Worigin0314/2025-USTB--IoT-Engineering--Electronic_Circuit_practice/README.md

2025学年北京科技大学物联网工程专业-电子电路实践<br>
这门课算是非常轻松的一门课了，完全跟着老师发的PDF来，结课报告让AI润色一下就是90+，实验操作课上完全能完成，杨XX老师讲的也不错，动手操作环节不难而且很有意思<br>
记得要验收，最后灯体装完了也要验收
