Worigin0314/2025-USTB--IoT-Engineering--Electronic_Circuit_practice/4、2025-讲语音设计及固件烧录-CI1302.pdf

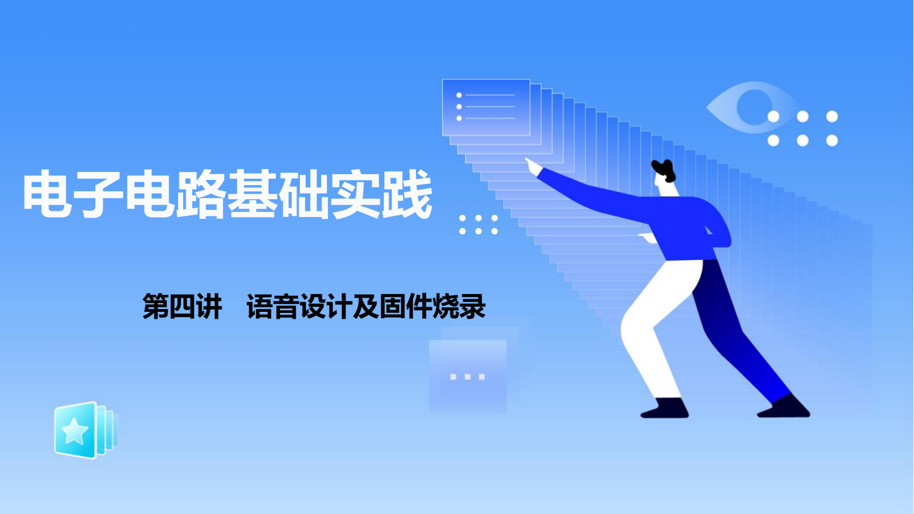
[picture p5: page 1]

# 电子电路基础实践

## 第四讲 语音设计及固件烧录

# 语音模块测试

## 1、CI-C22GS02S模块：

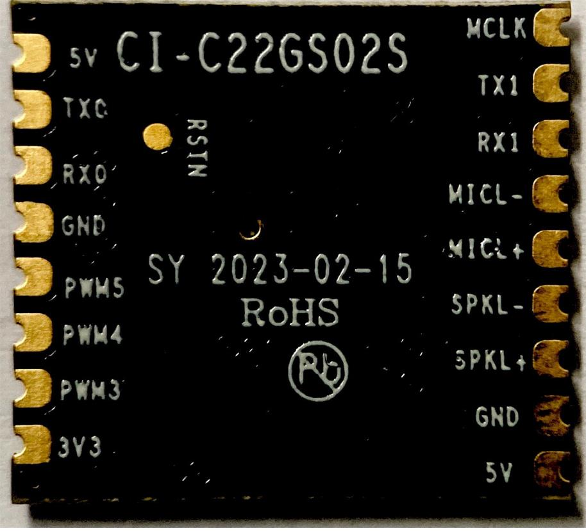
[picture p6: figure]
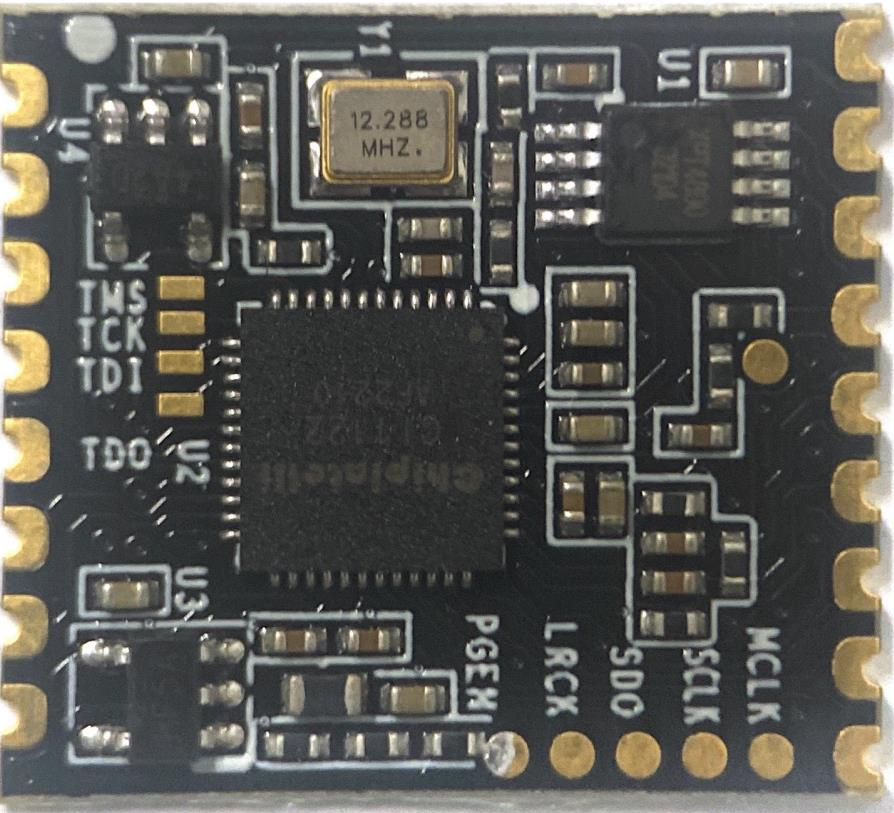
[picture p7: figure]

该模块包括语音识别芯片CI1122、功放等。语音指令从麦克风输入，经语音识别IC进行语音识别、指 令处理后，将反馈播报音发送至音频功放，驱动喇叭播放声音。

单麦离线语音识别模块

# 语音模块测试

## 1、CI-C22GS02S模块：

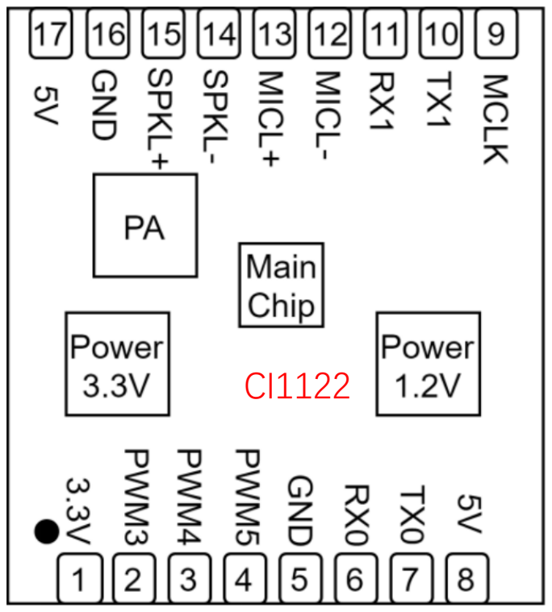
[picture p8: figure]

管脚图

CI1122是一颗专用于语音处理的人工智能芯片，可广泛应用于家 电、家居、照明、玩具、穿戴设备、汽车等产品领域，实现语音交互 及控制。CI1122内置自主研发的脑神经网络处理器BNPU，支持本地 语音识别，与内置的CPU核结合可以做各类智能语音方案应用。

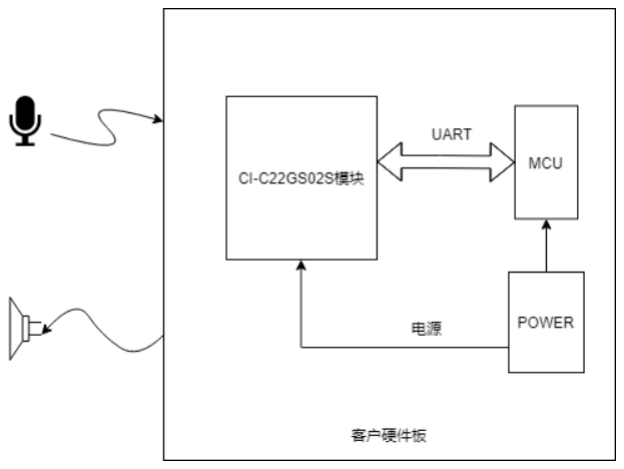
[picture p9: figure]

语音模块应用示意图

# 语音模块测试

## 1、CI-C22GS02S模块：

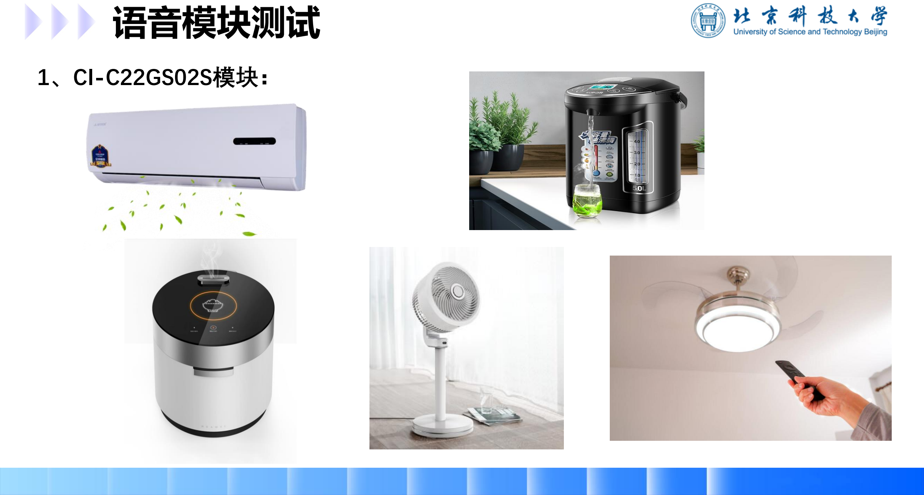
[picture p10: page 4]

# 语音模块测试

## 1、CI-C22GS02S模块：

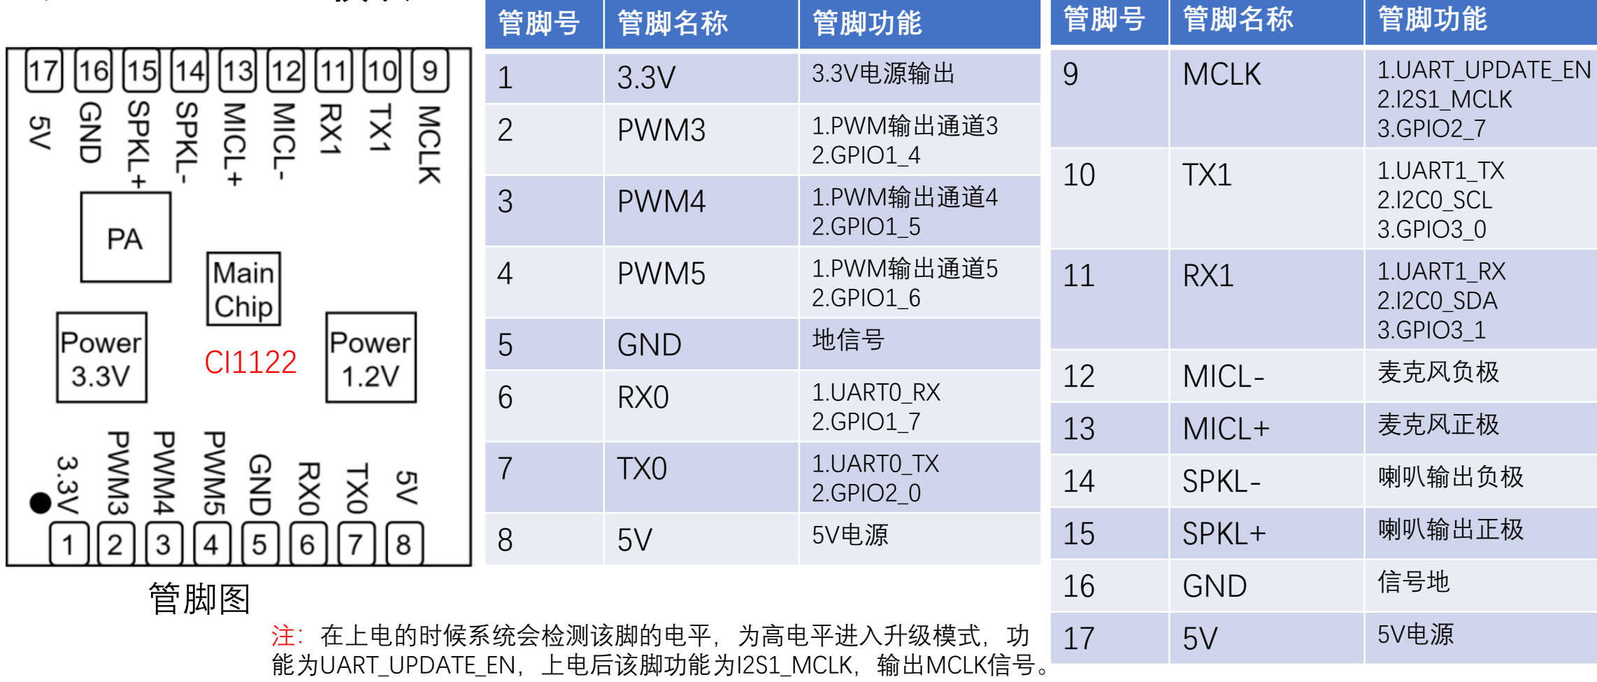
[picture p11: figure]
管脚图; 管脚号; 管脚名称; 管脚功能; 3.3V电源输出; MCLK; 1.UART_UPDATE_EN 2.I2S1_MCLK 3.GPIO2_7; PWM3; 1.PWM输出通道3 2.GPIO1_4; PWM4; 1.PWM输出通道4 2.GPIO1_5; PWM5; 1.PWM输出通道5 2.GPIO1_6; 1.UART1_RX 2.I2C0_SDA 3.GPIO3_1; GND; 地信号; 1.UART0_RX 2.GPIO1_7; 1.UART0_TX 2.GPIO2_0; 5V电源; 1.UART1_TX 2.I2C0_SCL 3.GPIO3_0; MICL-; 麦克风负极; MICL+; 麦克风正极; SPKL-; 喇叭输出负极; SPKL+; 喇叭输出正极; 信号地; 注：在上电的时候系统会检测该脚的电平，为高电平进入升级模式，功; 能为UART_UPDATE_EN，上电后该脚功能为I2S1_MCLK，输出MCLK信号。

# 硬件电路

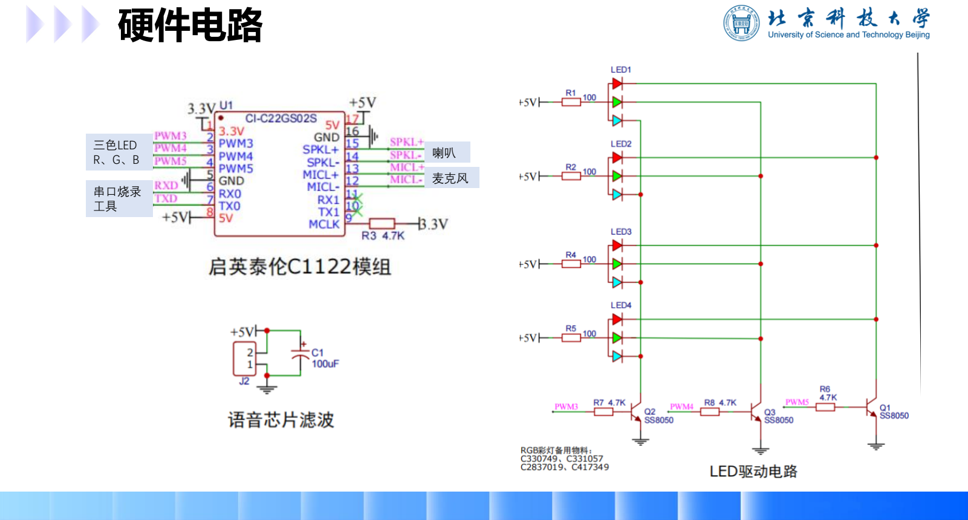
[picture p12: page 6]

三色LED
R、G、B

串口烧录
工具

喇叭

麦克风

# 实验原理

1、PWM

PWM(Pulse Width Modulation,脉冲宽度调制)是一种对模拟信号电平进行数字编码的方式，通 过不同频率的脉冲，以及使用不同占空⽐的方波来对一个具体的模拟信号进行电平编码，使输出 端得到一系列幅值相等的脉冲，用这些脉冲来代替所需要波形的设备。

占空比：是指一串理想脉冲序列中，正脉冲的持续时间与脉冲总周期的⽐值。调整LED通过电流和 不通过电流的时间⽐来控制，由于人眼有视觉暂留特性，所以只要频率⽐较高是看不出来闪烁的。 当然通过电流⽐不通过电流的时间⽐例越大，LED也就越亮。

每11毫秒闪烁一次约83赫兹基

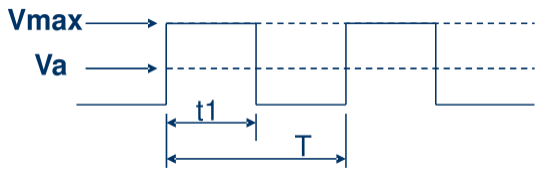
[picture p13: figure]

除了在调光电路应用，还有在直流斩波电路、蜂鸣器驱动、电机驱动、逆变电路、加湿机雾化量等 都会有应用。

# 实验原理

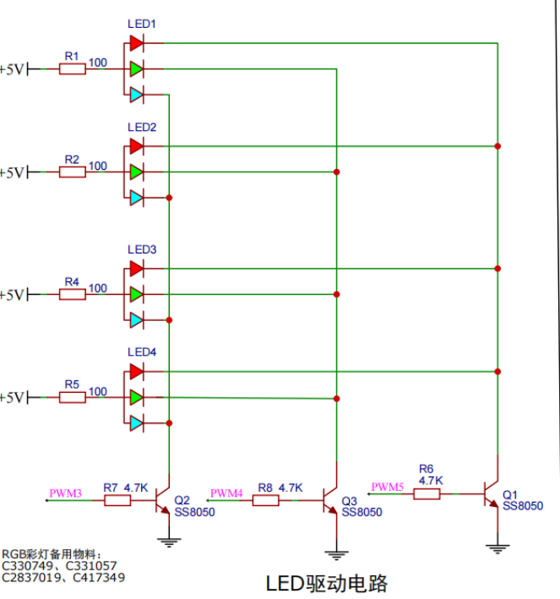
[picture p14: figure]

三色LED灯为共阳极，阳极通过限流电阻与5V电源相连。 红色LED阴极，与三极管Q1集电极相连；
LED阴极，与三极管Q2集电极相连；
绿色LED阴极，与三极管Q3集电极相连。
语音模块的PWM输出端口PWM3、PWM4、PWM5、 分别通过限流电阻与三级管的基极连接。
当PWM端口输出高电平时，三极管工作在饱和状态，
LED导通，发出亮光。当PWM输出低电平时，三极管
截止，LED不导通。

2、LED亮、灭控制原理

# 实验原理

CI1122芯片API

3、语音模块PWM端口

启英泰伦智能语音平台：https://aiplatform.chipintelli.com/begin

函数名 | 功能描述
pwm_init | 初始化PWM设备
pwm_start | 启动PWM设备
pwm_stop | 停止PWM设备
pwm_set_duty | 设置PWM占空⽐

Scu_SetDeviceGate(HAL_PWM0_BASE,ENABLE); Scu_SetIOReuse(PWM0_PAD,SECOND_FUNCTION); Scu_SetIOPull(PWM0_PAD,DISABLE);//关闭IO内部上下拉 pwm_init_t init;
init.clk_sel = 0;
init.freq = 1000;
init.duty = 50;
init.duty_max = 100;
pwm_init(PWM0,init);
pwm_stop(PWM0);
pwm_start(PWM0);

CI1122相关头⽂件引用 #include "ci112x_pwm.h" #include "ci112x_scu.h"

实例应用

# 软件及代码烧录

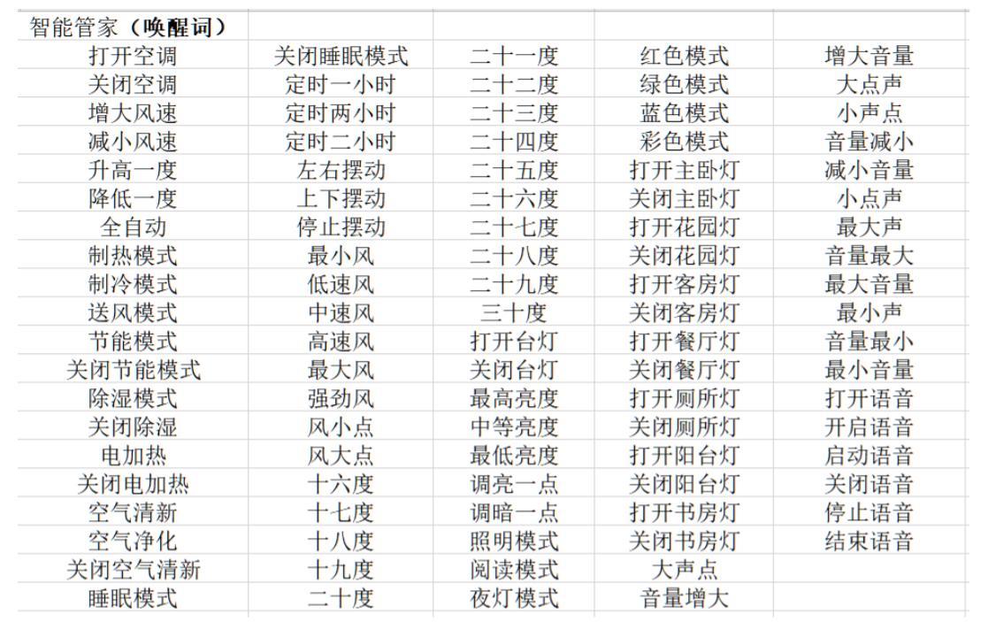
[picture p15: figure]

启英泰伦的语音芯片支持自定义
开发，参考案例给出了已经写好的固
件，模块初次焊接上电后会出现出厂
配置的语音，可以做一个测试，看麦
克风与喇叭是否正常工作，测试指令
如右图。

1、启英泰伦芯片测试

# 软件及代码烧录

由于默认测试词条智能测试简单的对话，无法对 IO 口进行控制。为了便于初学者快速入门制作一个离线 语音控制的小台灯，我们专门提供了一个固件，将固件烧写到芯片里面后就可以做出一个语音控制的小夜灯啦

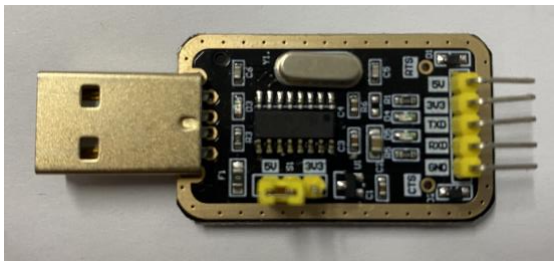
[picture p16: figure]

。

2、小夜灯固件烧录

### 2.1 烧录工具

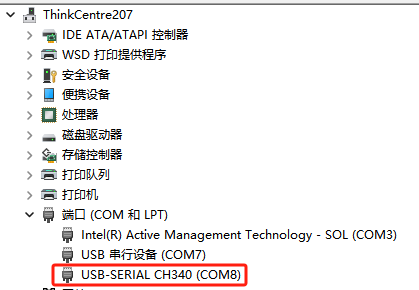
[picture p17: figure]

固件烧写需要事先准备一个 USB 转 TTL的电路模块，先将模块接入电脑，在设备管理器中查看是否识 别，如果没有识别需要安装一个对应驱动。记住插入设备显示是 COM 几的接口。

# 软件及代码烧录

2、小夜灯固件烧录

### 2.2 固件下载

（1）打开 CI130X_SDK_V1.5.9\projects\cwsl_sample\firmware目录 （2）双击运行“合成分区 bin ⽂件”（.bat 格式） （3）等待转换完成后，窗口自动关闭

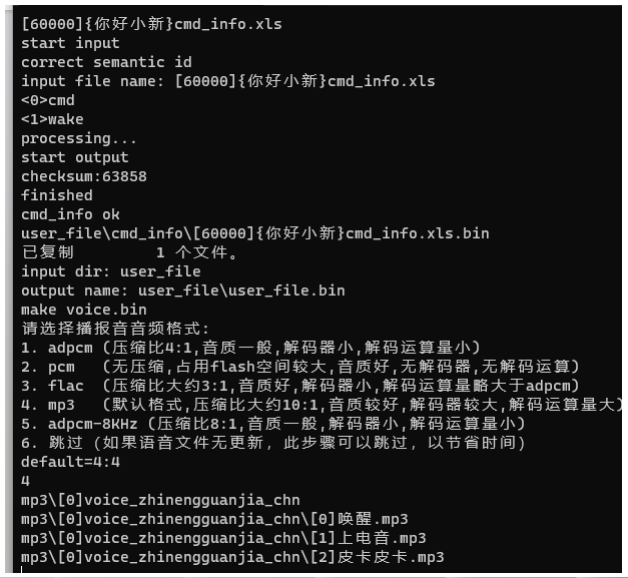
[picture p18: figure]

# 软件及代码烧录

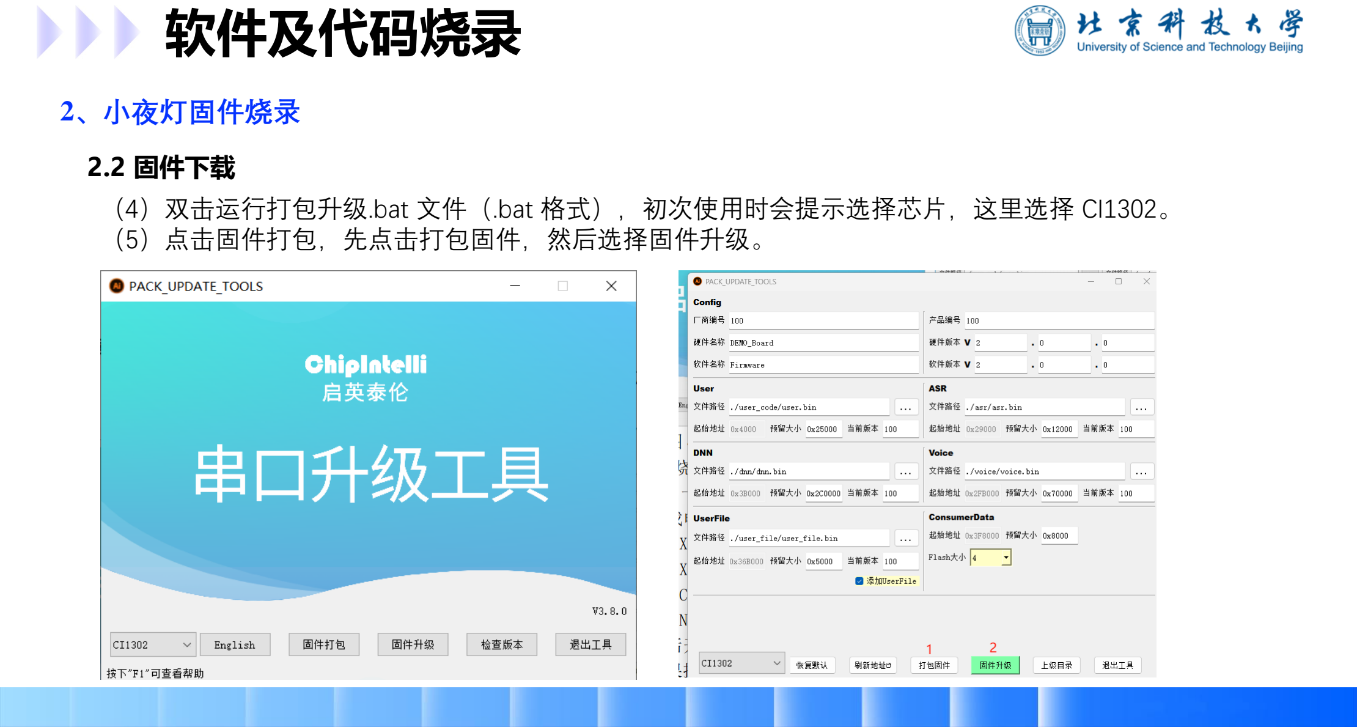
[picture p19: page 13]

2、小夜灯固件烧录

### 2.2 固件下载

（4）双击运行打包升级.bat ⽂件（.bat 格式），初次使用时会提示选择芯片，这里选择 CI1302。 （5）点击固件打包，先点击打包固件，然后选择固件升级。

# 软件及代码烧录

2、小夜灯固件烧录

### 2.2 固件下载

（6）固件烧写。固件升级后会跳转到固件烧写页面，接入 USB 转 TTL 模块，选择识别出来的串口号（一 般默认识别）。右侧点击勾上即可进入下载模式。然后再把小夜灯电路的串口接口与下载电路连接，接线 如下：
小夜灯的 TXD 引脚——下载器的 RXD 引脚
小夜灯的 RXD 引脚——下载器的 TXD 引脚
小夜灯的 VCC 引脚——下载器的 VCC 引脚
小夜灯的 GND 引脚——下载器的 GND 引脚

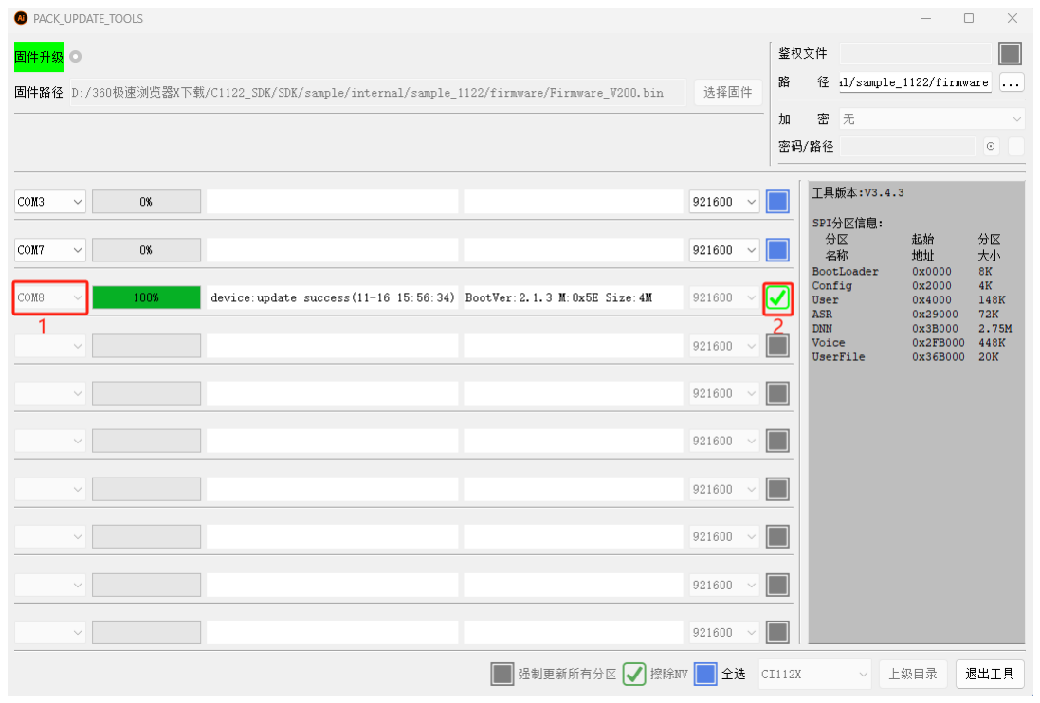
[picture p20: figure]

接上后开始下载，看图中进度条，当进度条显
示 device：update success 时固件烧录完成。如果 接上线后不进入下载模式，可拔掉电路板上的 VCC
线后重新插入即可。

# 软件及代码烧录

3、默认指令说明

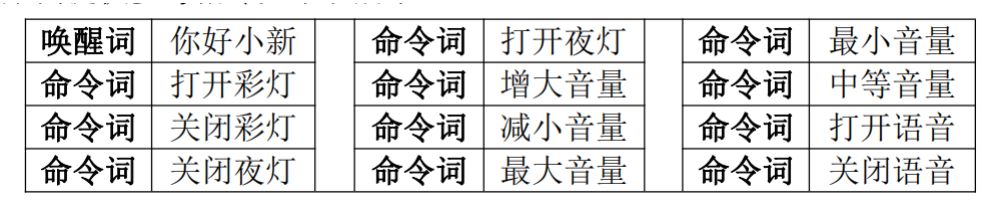
[picture p21: figure]

# 安装灯体

## 1. 程序烧录测试确认无误后，拆开灯体旋下螺钉，将原有电路板拆卸下来，再装好螺钉；

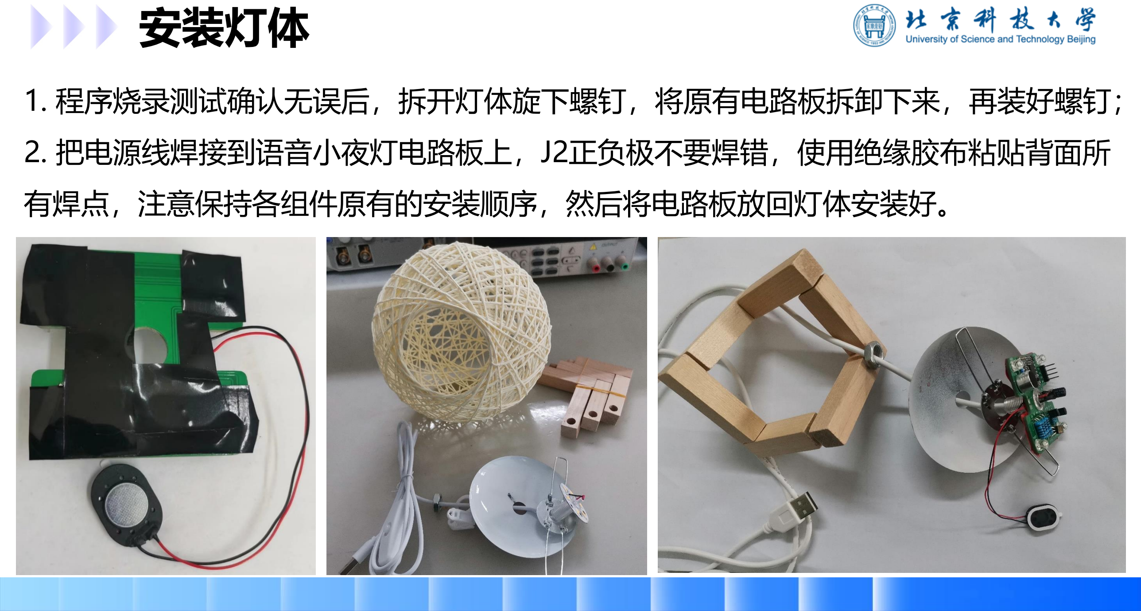
[picture p22: page 16]

## 2. 把电源线焊接到语音小夜灯电路板上，J2正负极不要焊错，使用绝缘胶布粘贴背面所

## 有焊点，注意保持各组件原有的安装顺序，然后将电路板放回灯体安装好。

# 实验结果

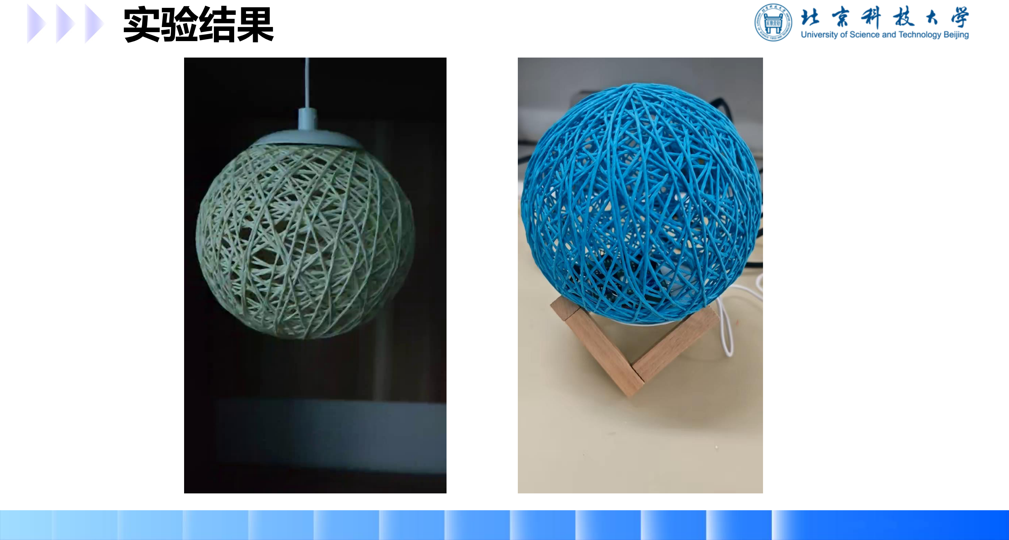
[picture p23: page 17]

# 进阶--自定义词条设置

## 生成自己设置的词条或 者指令，完成个性化、定

## 制化智能语音小夜灯。

## 启英泰伦AI平台：

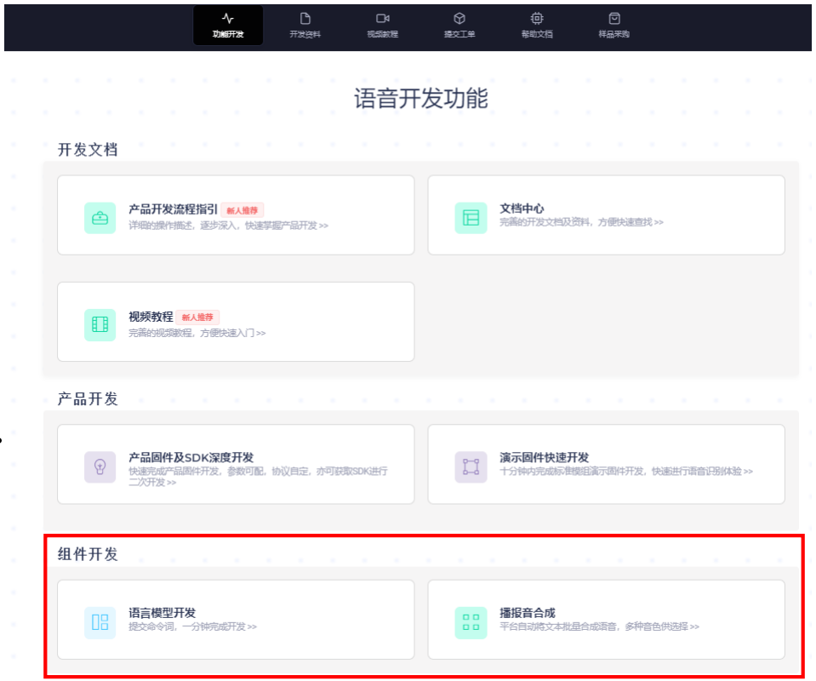
[picture p24: figure]

https://aiplatform.chipintelli.

## com/begin

# 进阶--自定义词条设置

语言模型开发

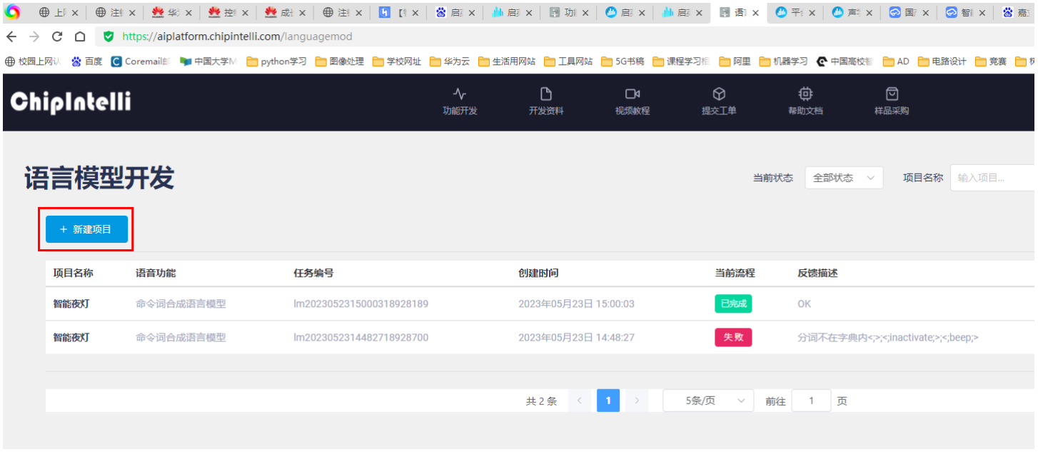
[picture p25: figure]

# 进阶--自定义词条设置

语言模型开发

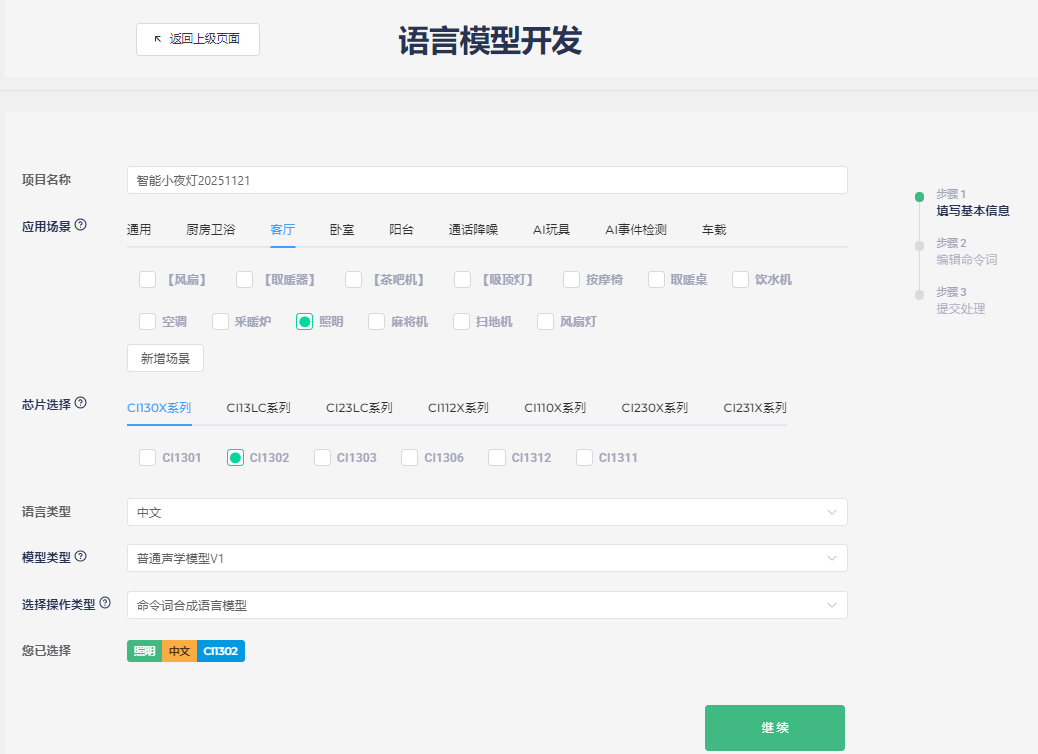
[picture p26: figure]

# 进阶--自定义词条设置

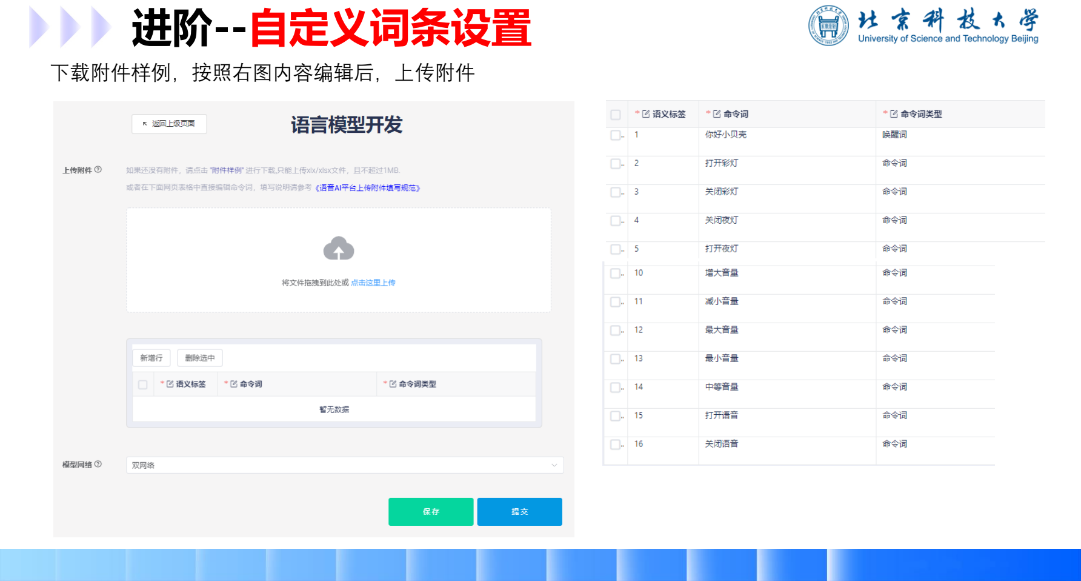
[picture p27: page 21]

下载附件样例，按照右图内容编辑后，上传附件

# 进阶--自定义词条设置

选择语言模型

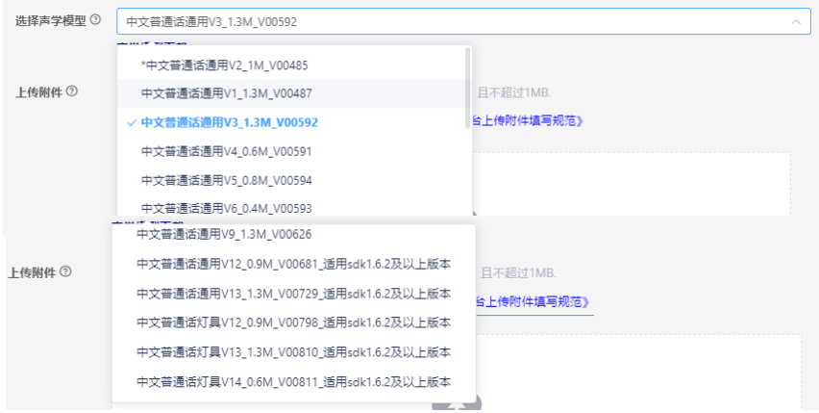
[picture p28: figure]

# 进阶--自定义词条设置

语言模型开发

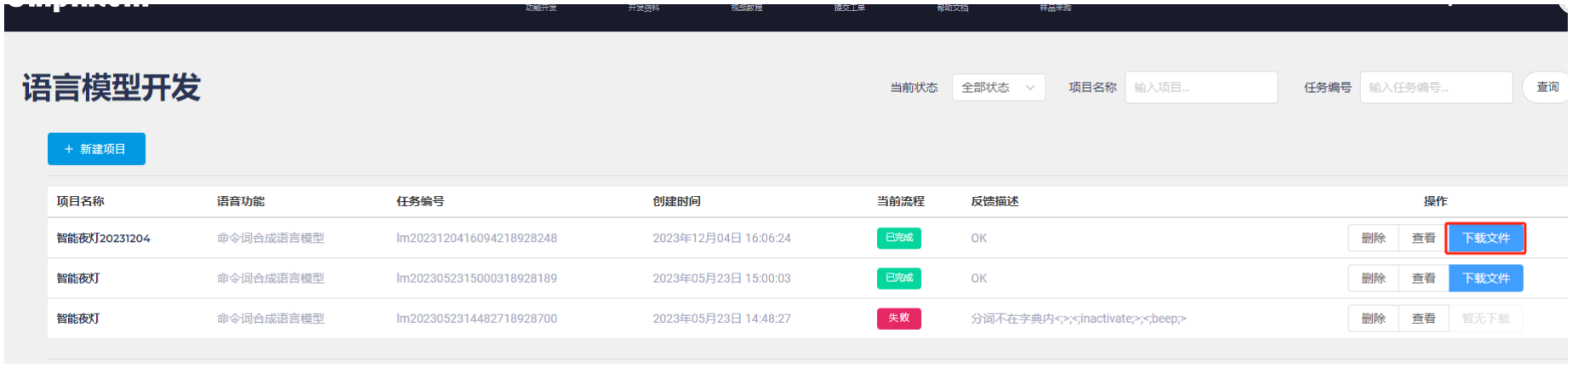
[picture p29: figure]

如果您使用的是CI11XX SDK，请按如下步骤将合成的⽂件拷贝到SDK中： 1、根据命令词修改⽂件：[60000]{你好小新}cmd_info.xls 路径：CI130X_SDK_V1.5.9\projects\cwsl_sample\firmware\user_file\cmd_info⽂件夹下；
2、将 GfstCmd\[0]*.dat ⽂件替换SDK的 CI130X_SDK_V1.5.9\projects\cwsl_sample\firmware\asr⽂件夹下 [0]*.dat 。
3、将 GfstWake\[1]*.dat ⽂件替换SDK的 CI130X_SDK_V1.5.9\projects\cwsl_sample\firmware\asr⽂件夹下 [1]*.dat。

# 进阶--自定义词条设置

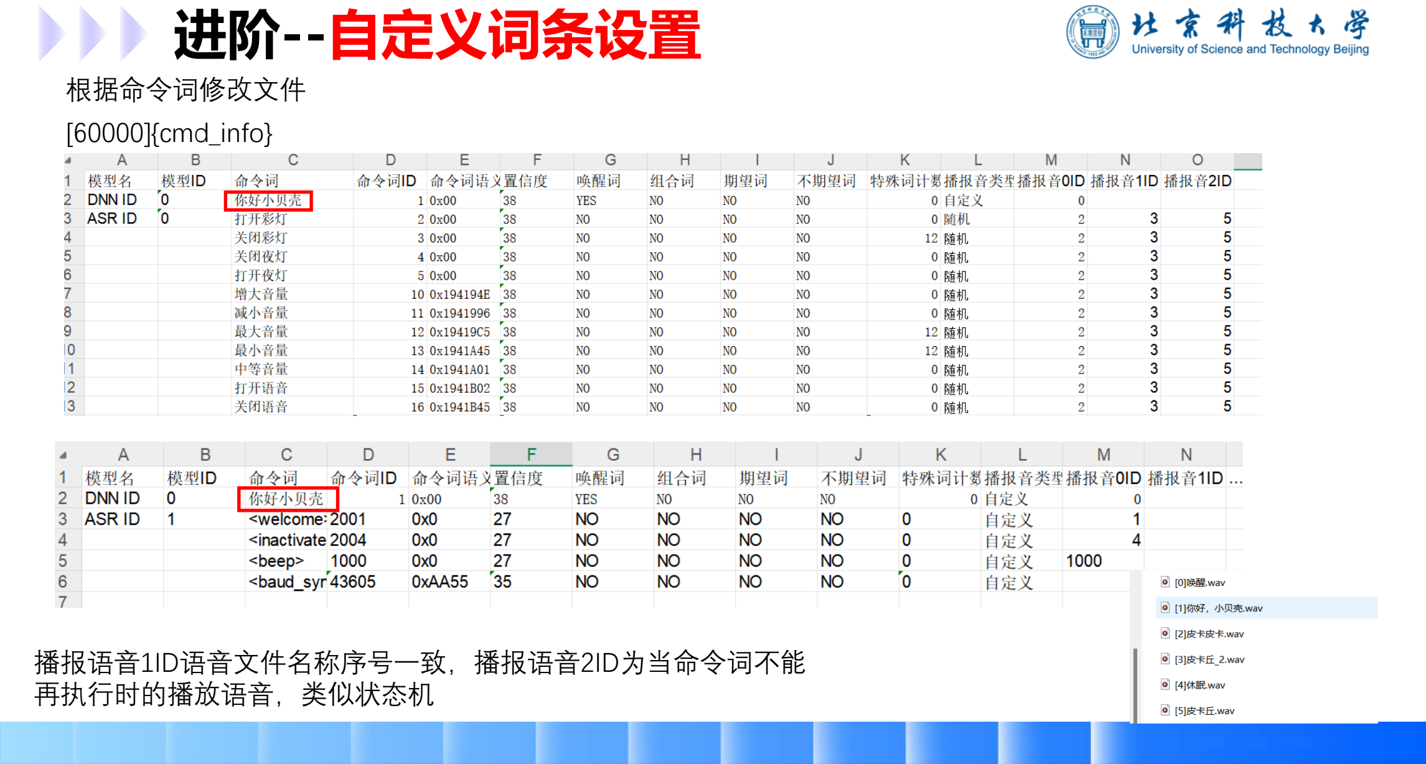
[picture p30: page 24]

根据命令词修改⽂件
[60000]{cmd_info}

播报语音1ID语音⽂件名称序号一致，播报语音2ID为当命令词不能 再执行时的播放语音，类似状态机

# 进阶--自定义词条设置

替换⽂件

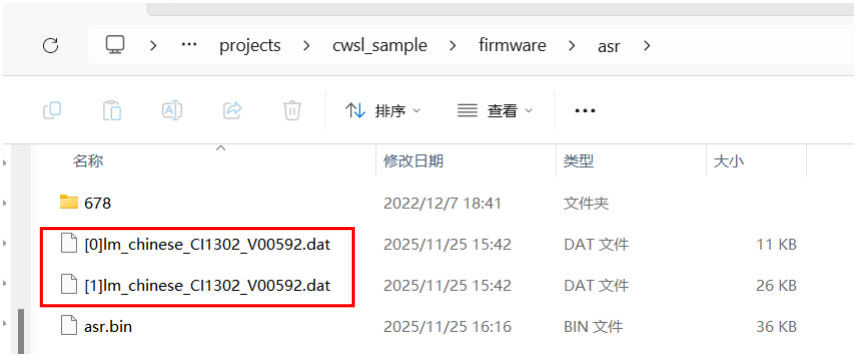
[picture p31: figure]

# 进阶--自定义词条设置

语音合成

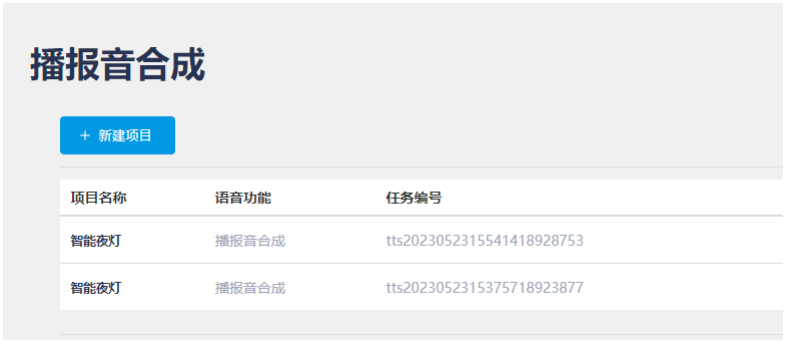
[picture p32: figure]

# 进阶--自定义词条设置

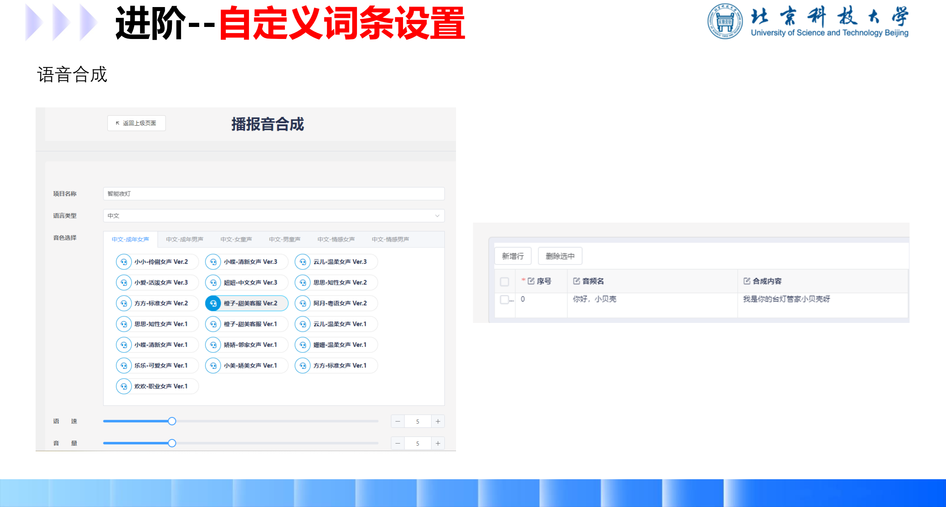
[picture p33: page 27]

语音合成

# 进阶--自定义词条设置

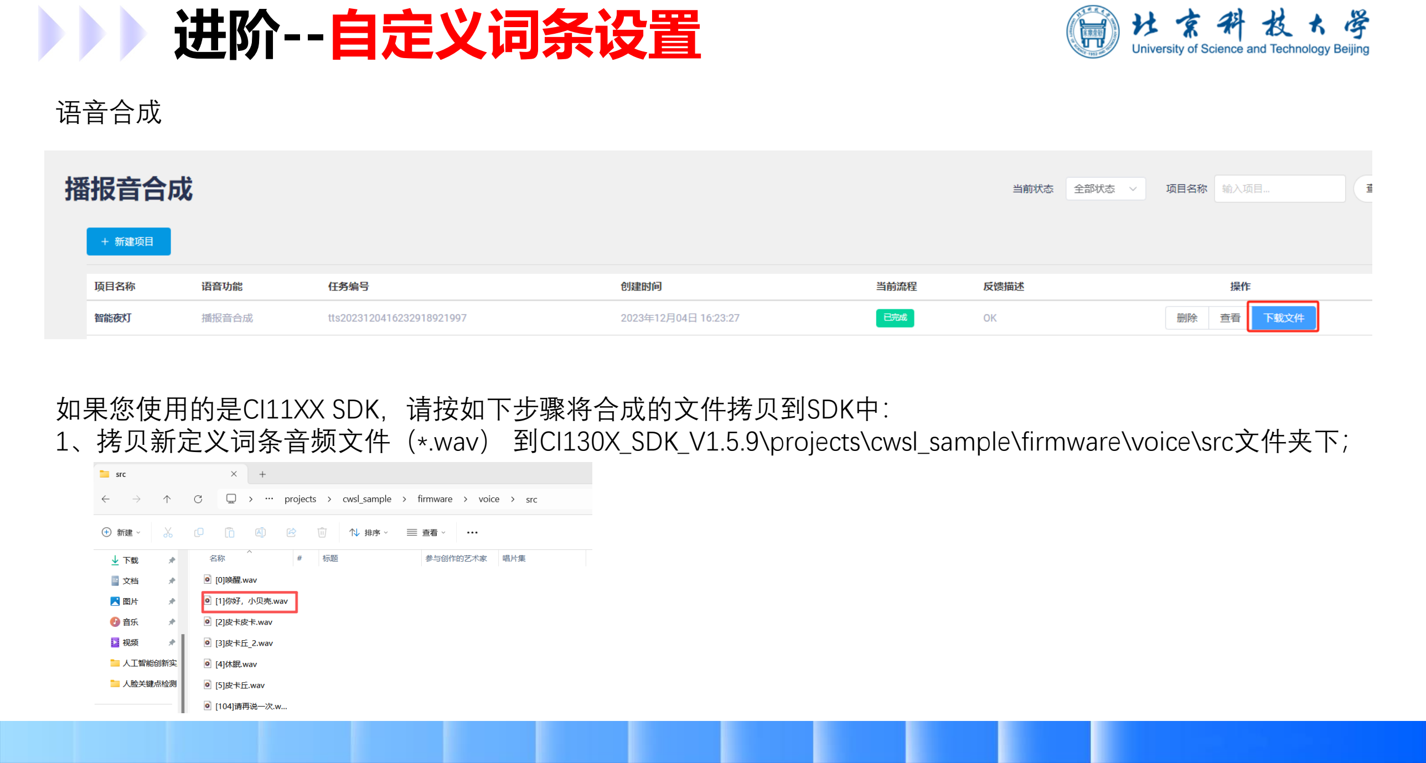
[picture p34: page 28]

语音合成

如果您使用的是CI11XX SDK，请按如下步骤将合成的⽂件拷贝到SDK中： 1、拷贝新定义词条音频⽂件（*.wav） 到CI130X_SDK_V1.5.9\projects\cwsl_sample\firmware\voice\src⽂件夹下；

# 进阶--自定义词条设置

烧录

修改完成后按照之前的烧录流程进行烧录即可。
验证

烧录完成后按序验证语音词条是否生效。
