Worigin0314/2025-USTB--IoT-Engineering--Electronic_Circuit_practice/3、焊接机理和焊接方法- 专业版.pdf

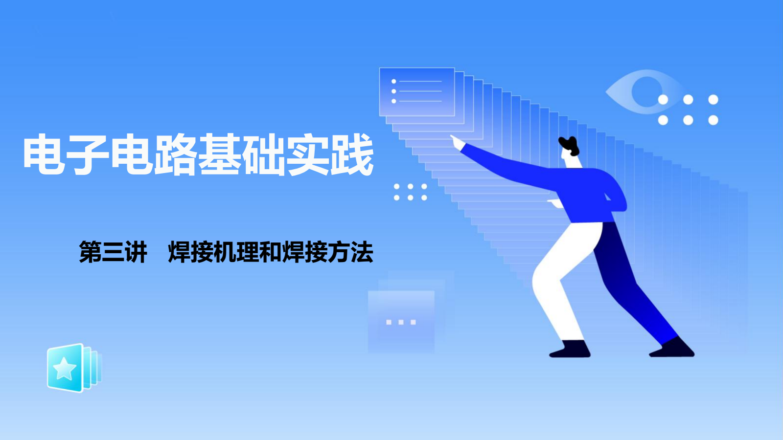
[picture p35: page 1]

# 电子电路基础实践

### 第三讲 焊接机理和焊接方法

课程引入 | 顶部工具栏

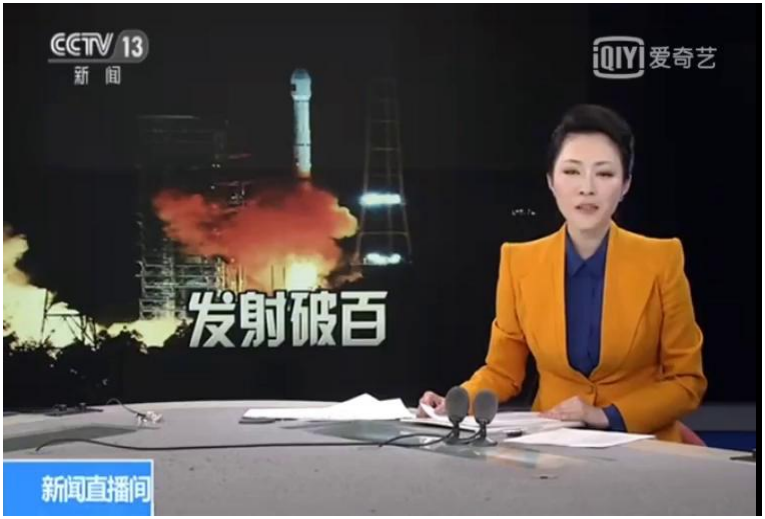
[picture p36: figure]

目录

Ø 焊接基本知识

Ø 手工焊接工具及材料

Ø 手工焊接的基本方法

Ø 电子焊接工艺

Ø 焊接大“狮”赛介绍

## 焊接基本知识

l 焊接机理概述

l 润湿作用

l 表面张力

l 毛细管现象

l 扩散

l 焊接界面结合层

## 焊接基本知识—焊接机理概述

焊接：利用加热或加压，在两种金属的接触面，通过焊接材料 的原子或分子的相互扩散作用，使两种金属间形成一种永久的牢固 结合。
利用焊接的方法而形成的接点叫焊点。焊接通常分为熔焊、压 焊及钎焊三大类，在电子装配中主要使用的是钎焊。
按焊料熔点的高低不同又将钎焊分为“硬钎焊”和“软钎焊”

，
通常以450℃为界，低于450℃的称为“软钎焊”

。电子产品安装属
于软钎焊的一种。

## 焊接基本知识—焊接机理概述

焊接机理：从物理学的角度来看，任何焊接都是一个“扩散” 的过程，是一个在高温下两个或两个以上物体表面分子相互渗透 的过程。锡焊，就是让熔化的焊料渗透到两个被焊物体（比如元 器件引脚与印刷电路板焊盘）的金属表面分子中，然后冷凝而使 之结合。

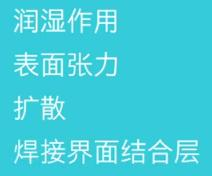
[picture p37: figure]

### 焊接机理组成：

## 焊接基本知识—润湿作用

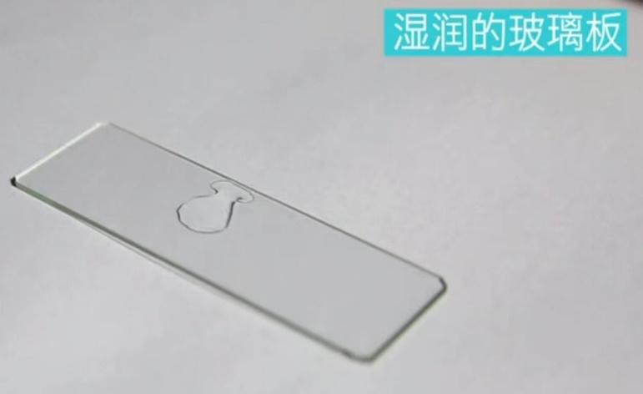
[picture p38: figure]
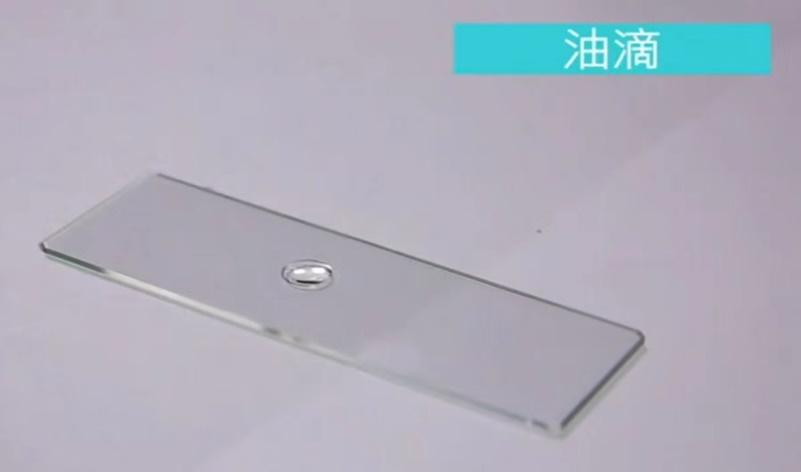
[picture p39: figure]
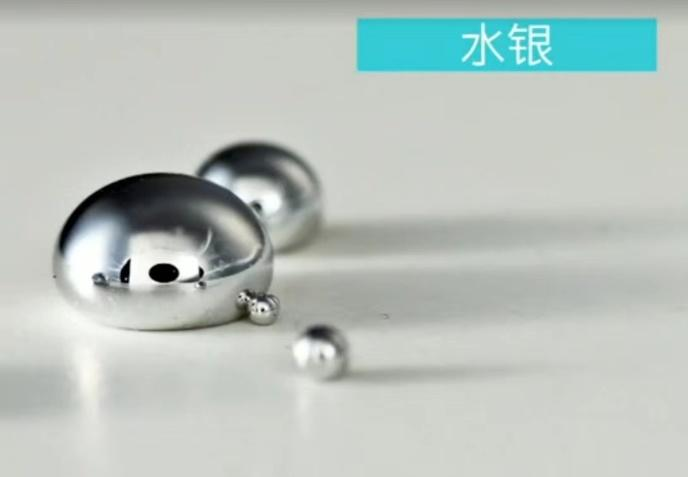
[picture p40: figure]

加热后呈熔融状态的焊料，沿着工件金属的凹凸表面，靠毛细 管的作用扩展。如果焊料和工件金属表面足够清洁，焊料原子与工 件金属原子就可以接近到能够相互结合的距离，即接近原子引力相 互作用的距离，上述过程称为焊料的润湿。

## 焊接基本知识—润湿作用

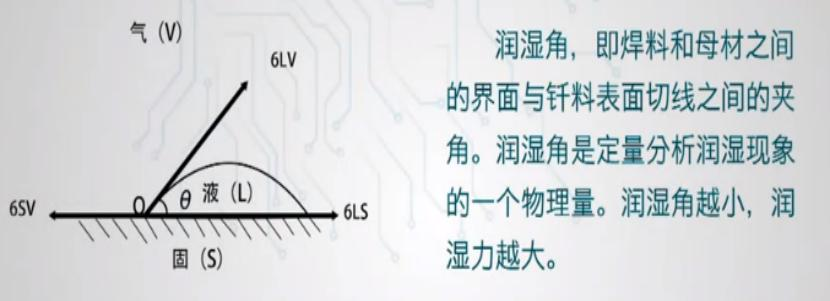
[picture p41: figure]

## 焊接基本知识—润湿作用

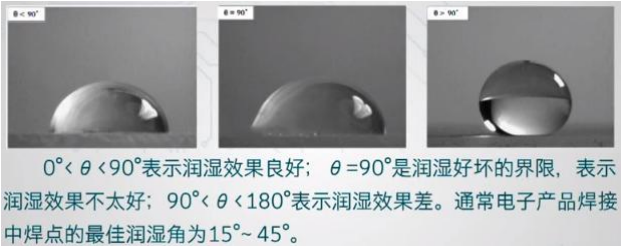
[picture p42: figure]

润湿作用必备条件：
Ø 液态焊料与母材之间应能互相溶解，即两种原子之间有良好的亲和力。 Ø 焊料和母材表面必须“清洁”

，没有污染。

## 焊接基本知识—表面张力

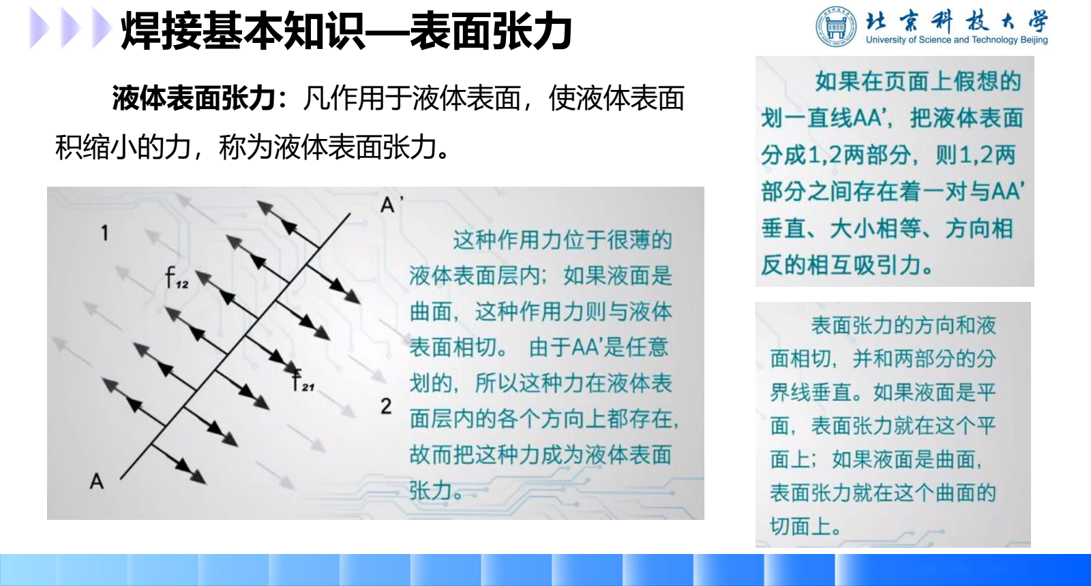
[picture p43: page 10]

液体表面张力：凡作用于液体表面，使液体表面
积缩小的力，称为液体表面张力。

## 焊接基本知识—表面张力

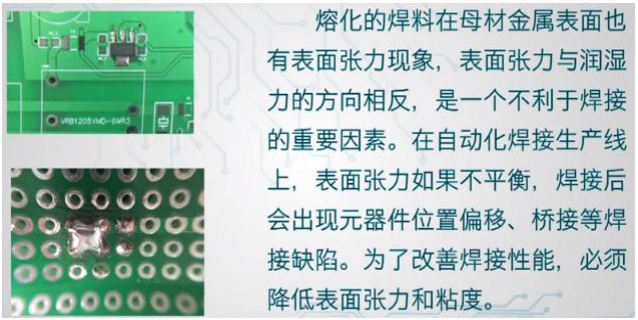
[picture p44: figure]

降低焊料表面张力的方法：

提高焊接温度

改善焊料的合金成分

改善焊接环境

增加活性剂

## 焊接基本知识—毛细管现象

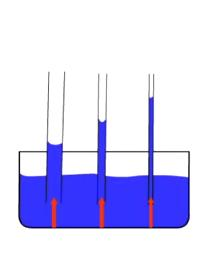
[picture p45: figure]

毛细管现象（虹吸现象）

将吸管插入水中时，水会进入吸管，使得
吸管中的液位要高于水平面。
吸管的内径必须要小，由于内径小，液体
分子爬在吸管内壁上会产生一个向上的拉力而
提起一定重量的液体。如果吸管内径太大，液
体太重，就不能将吸管内的液体提起来。

## 焊接基本知识—毛细管现象

毛细管现象在焊接中的作用：提高焊接强度

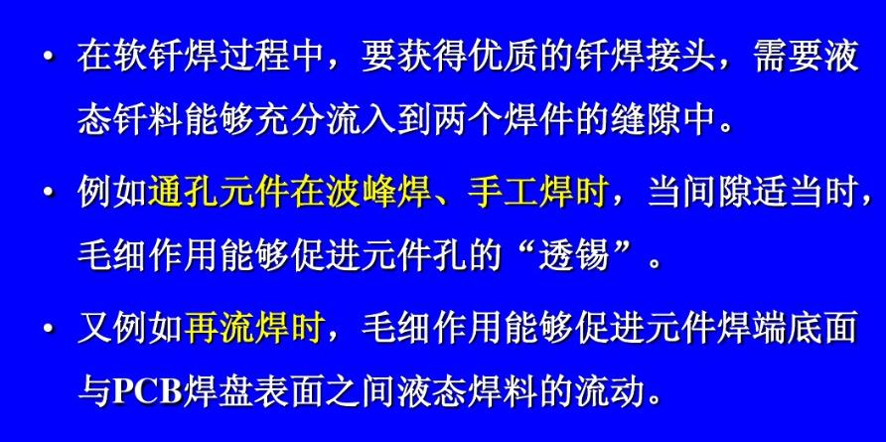
[picture p46: figure]

## 焊接基本知识—扩散

金属的扩散条件：

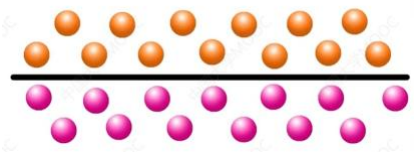
[picture p47: figure]

Ø 距离要足够小

Ø 达到一定温度

焊接中扩散程度的影响因素：

Ø 焊料的成分

Ø 母材金属的种类

Ø 加热温度等

焊料

界面

焊件

## 焊接基本知识—焊接界面结合层

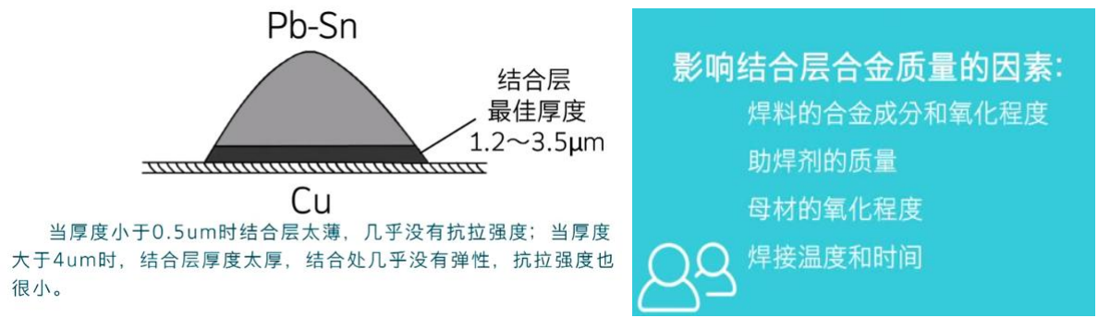
[picture p48: figure]

目录

Ø 焊接基本知识

Ø 手工焊接工具及材料

Ø 手工焊接的基本方法

Ø 电子焊接工艺

Ø 焊接大“狮”赛介绍

## 手工焊接工具及材料

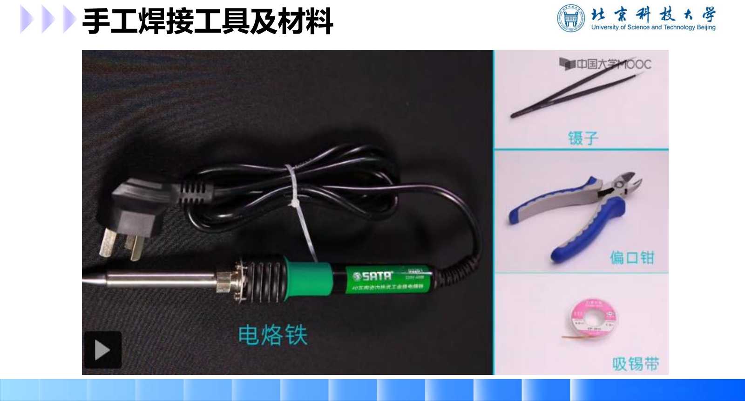
[picture p49: page 17]

## 手工焊接工具及材料—电烙铁

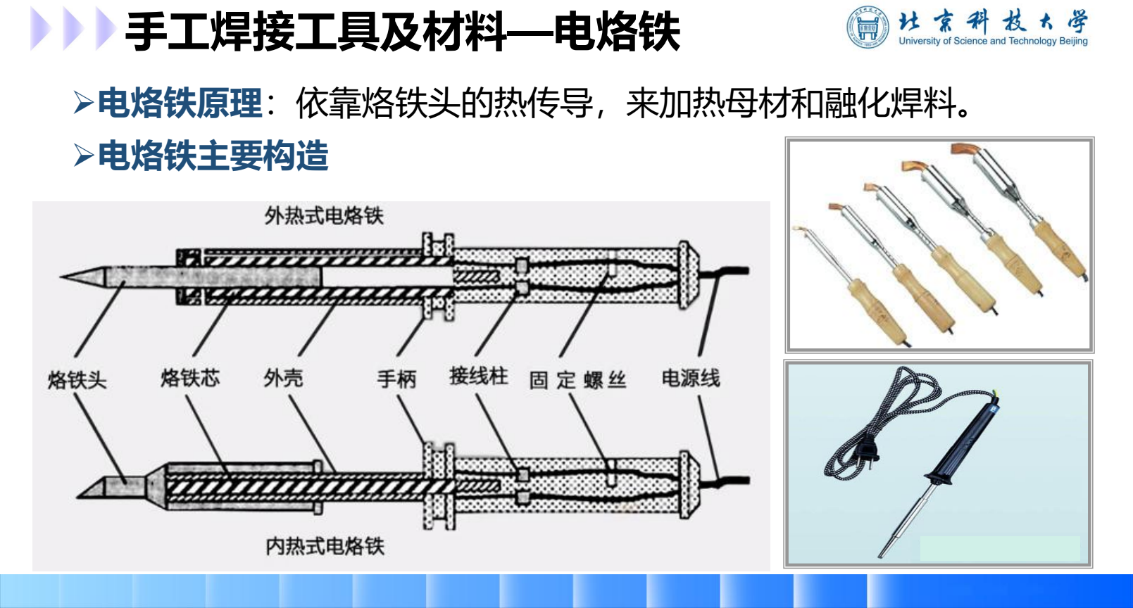
[picture p50: page 18]

Ø电烙铁原理：依靠烙铁头的热传导，来加热母材和融化焊料。

### Ø电烙铁主要构造

## 手工焊接工具及材料—电烙铁

Ø常见电烙铁的优缺点

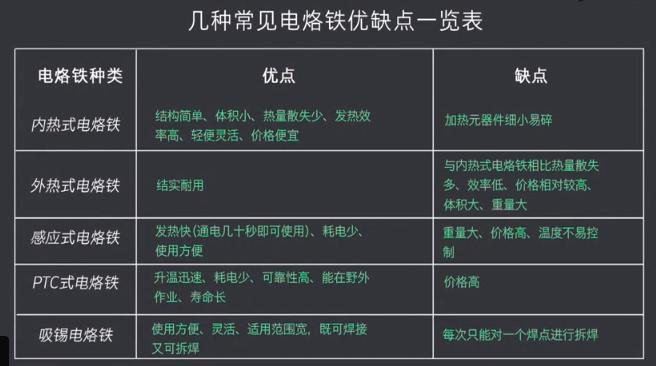
[picture p51: figure]

## 手工焊接工具及材料—电烙铁

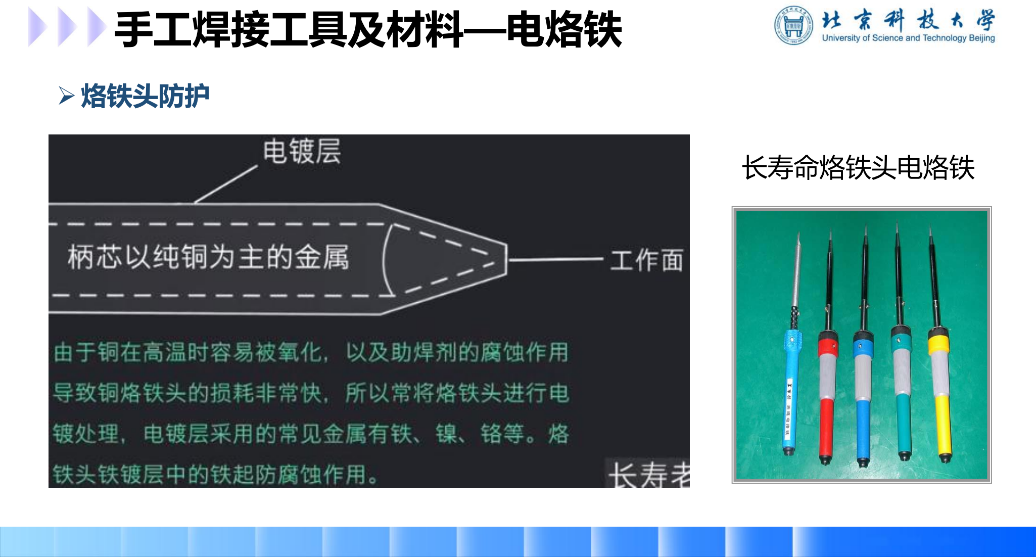
[picture p52: page 20]

Ø烙铁头防护

长寿命烙铁头电烙铁

## 手工焊接工具及材料—电烙铁

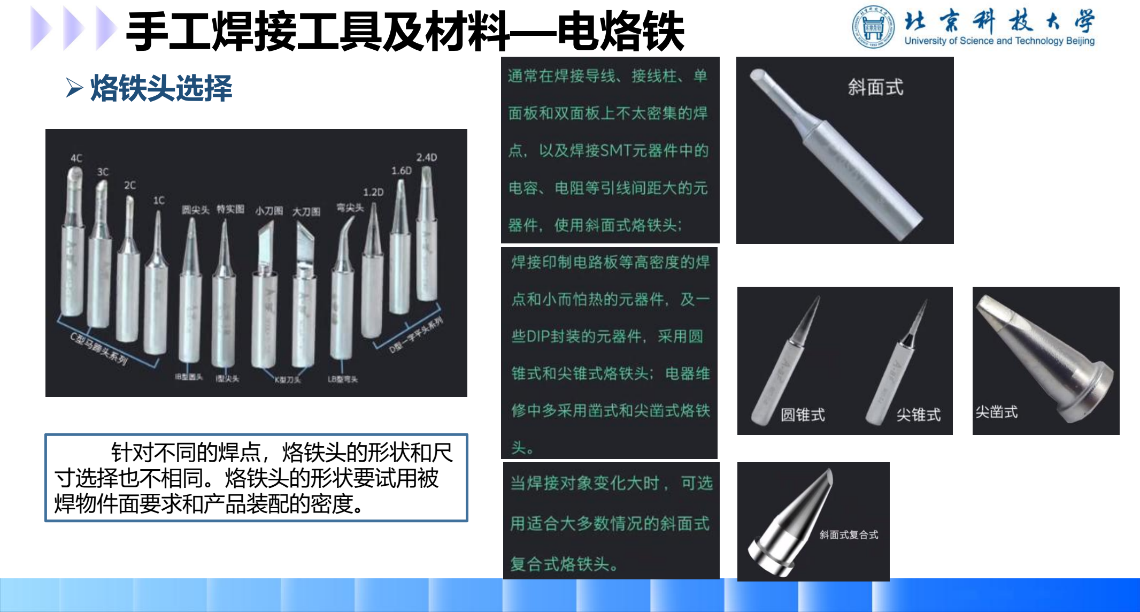
[picture p53: page 21]

Ø烙铁头选择

针对不同的焊点，烙铁头的形状和尺
寸选择也不相同。烙铁头的形状要试用被
焊物件面要求和产品装配的密度。

## 手工焊接工具及材料—电烙铁

1）烙铁头的直径决定了烙铁头的热容量
2）一般烙铁头的直径为焊盘尺寸的1.5倍
3）烙铁头尖端的面积应小于焊盘的面积，一般为2/3倍于焊盘尺寸 4）烙铁头尖端的温度一般要比焊料的熔点高30摄氏度到80摄氏度

### Ø烙铁头的热容量

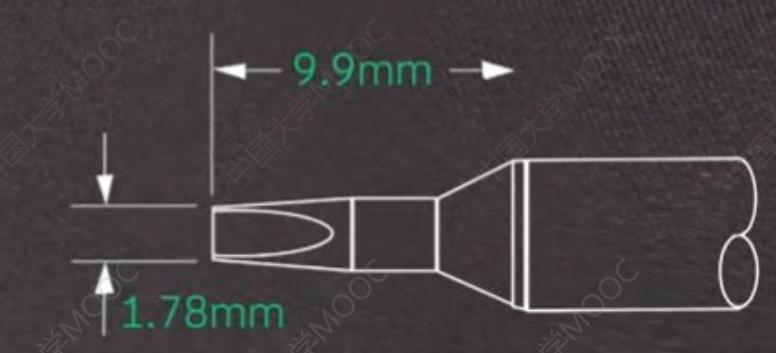
[picture p54: figure]

## 手工焊接工具及材料—电烙铁

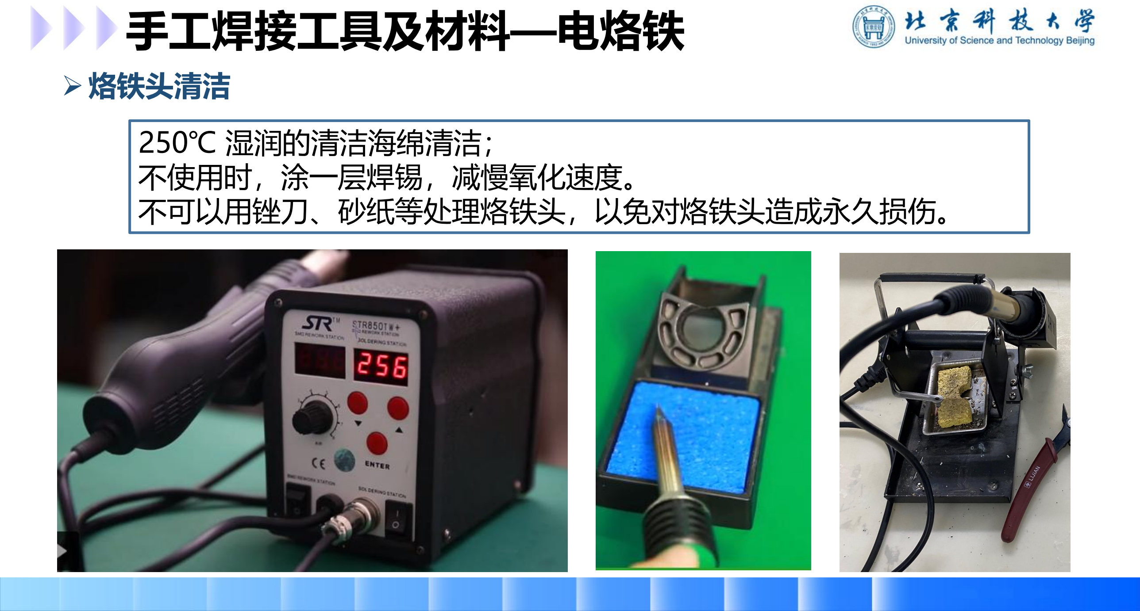
[picture p55: page 23]

Ø烙铁头清洁
250℃ 湿润的清洁海绵清洁；
不使用时，涂一层焊锡，减慢氧化速度。
不可以用锉刀、砂纸等处理烙铁头，以免对烙铁头造成永久损伤。

## 手工焊接工具及材料—电烙铁 请一定注意电烙铁的使用安全

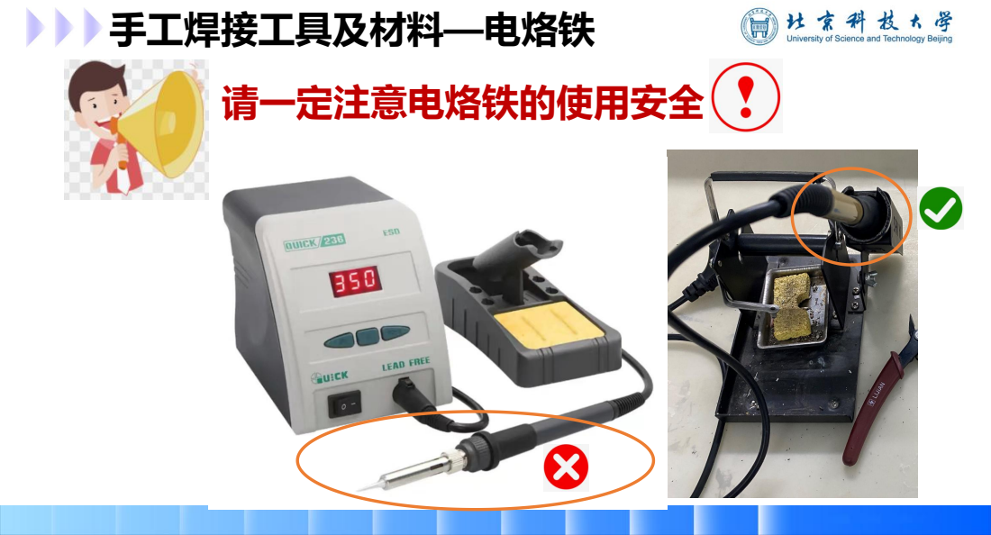
[picture p56: page 24]

## 手工焊接工具及材料—其他辅助工具

螺丝刀、刻刀、镊子、剥线钳、吸锡器、偏口钳等。

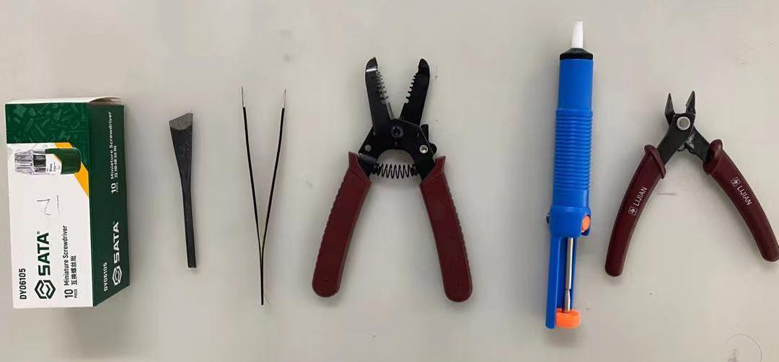
[picture p57: figure]

## 手工焊接工具及材料—焊料

铅与锡熔形成合金（即铅锡焊料）后，具有一系列铅和锡不具备的优点：

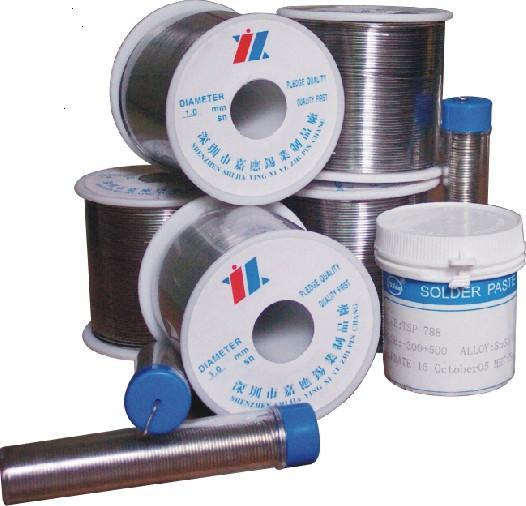
[picture p58: figure]
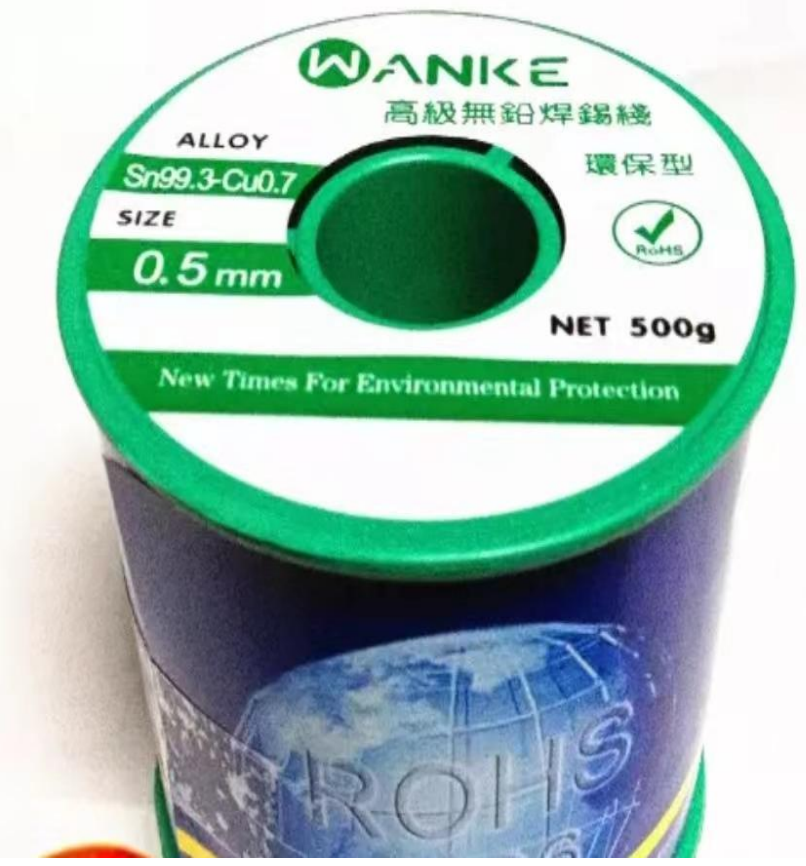
[picture p59: figure]

熔点低。各种不同成
分的铅锡合金熔点均低于
铅和锡的熔点，利于焊接。

表面张力小，增大了
液态流动性，有利于焊接
时形成可靠焊点。

## 手工焊接工具及材料—焊料

焊锡膏：灰色膏体，是由焊锡粉、助焊剂以及其
它的表面活性剂、触变剂等加以混合，形成的膏状混
合物。主要用于SMT行业PCB表面电阻、电容、IC等 电子元器件的焊接。
助焊剂：主要是去除金属表面的氧化层，方便焊
接。在手动焊接中多采用松香。印制电路板在制作过
程中一般表层涂有化学助焊剂。
松香水：松香酒精溶液涂在铜箔上，其中的酒精
很快地蒸发掉，松香在铜箔表面形成一层薄膜，可使
铜箔面始终保持光亮如新，防止氧化。
松香水的功能：防氧化和助焊。

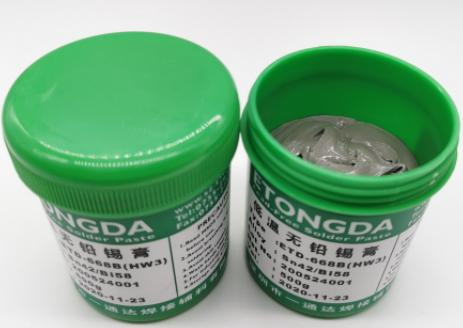
[picture p60: figure]
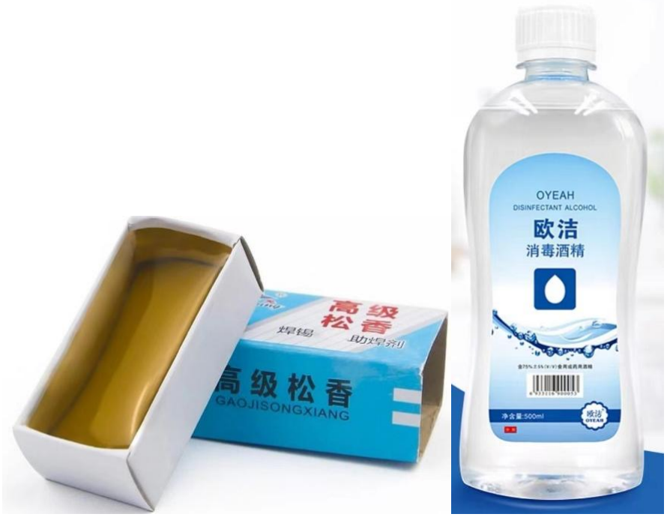
[picture p61: figure]

目录

Ø 焊接基本知识

Ø 手工焊接工具及材料

Ø 手工焊接的基本方法

Ø 电子焊接工艺

Ø 焊接大“狮”赛介绍

## 手工焊接的基本方法

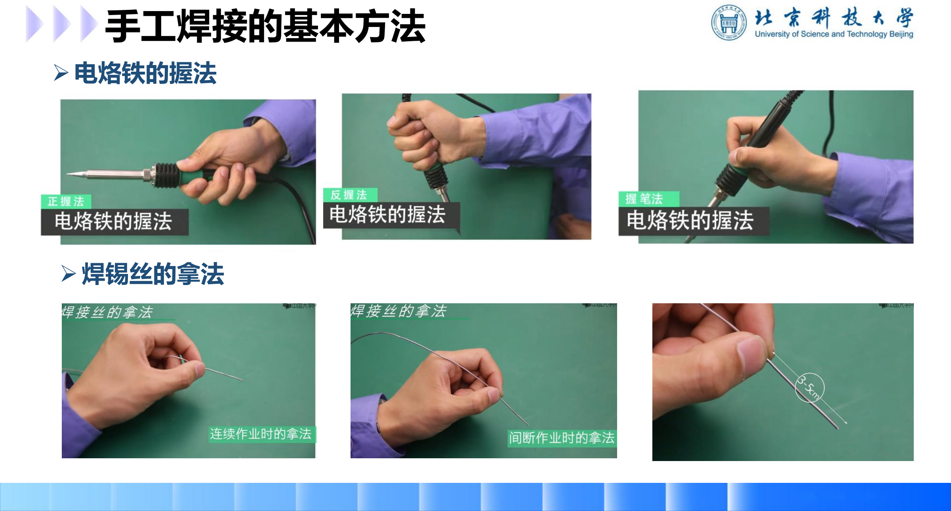
[picture p62: page 29]

Ø电烙铁的握法

Ø焊锡丝的拿法

## 手工焊接的基本方法—五步焊接法

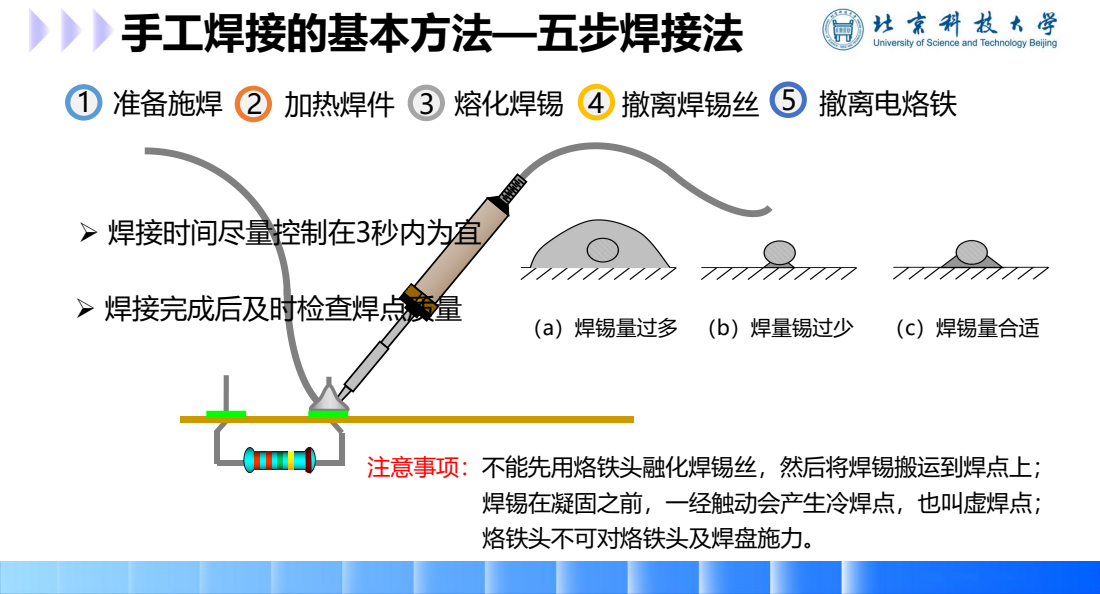
[picture p63: page 30]
Ø 焊接时间尽量控制在3秒内为宜; Ø 焊接完成后及时检查焊点质量

1 准备施焊 2 加热焊件 3 熔化焊锡 4 撤离焊锡丝 5 撤离电烙铁

（a）焊锡量过多 （b）焊量锡过少 （c）焊锡量合适

注意事项：不能先用烙铁头融化焊锡丝，然后将焊锡搬运到焊点上；

焊锡在凝固之前，一经触动会产生冷焊点，也叫虚焊点；
烙铁头不可对烙铁头及焊盘施力。

## 手工焊接的基本方法—五步焊接法

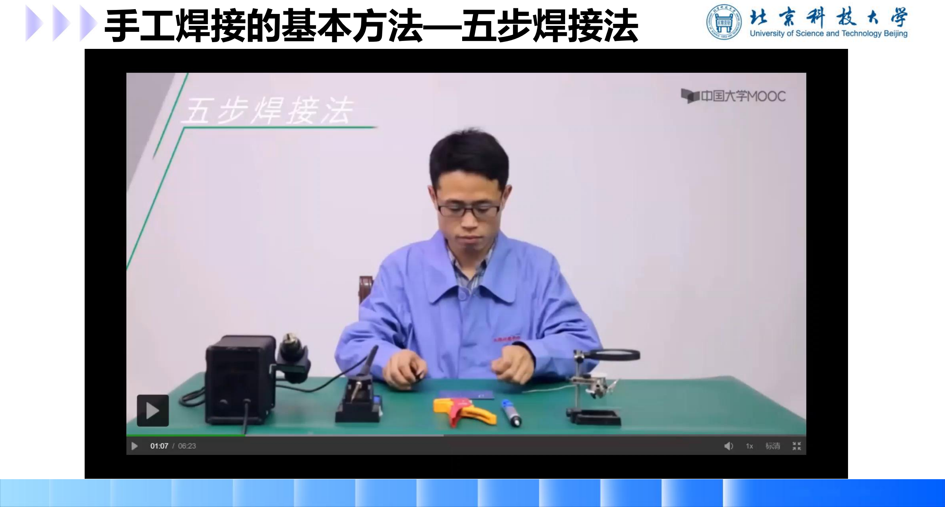
[picture p64: page 31]

## 手工焊接的基本方法—焊接要素

1）工件金属材料应具有良好的可焊性

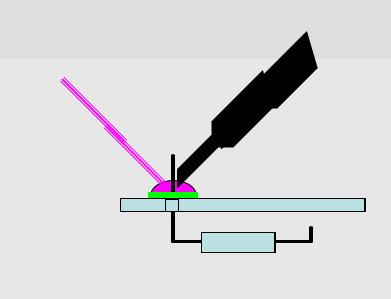
[picture p65: figure]

2）工件金属表面应洁净

3）正确选用助焊剂

4）正确选用焊料

5）控制焊接温度和时间

## 手工焊接的基本方法—焊点质量要求

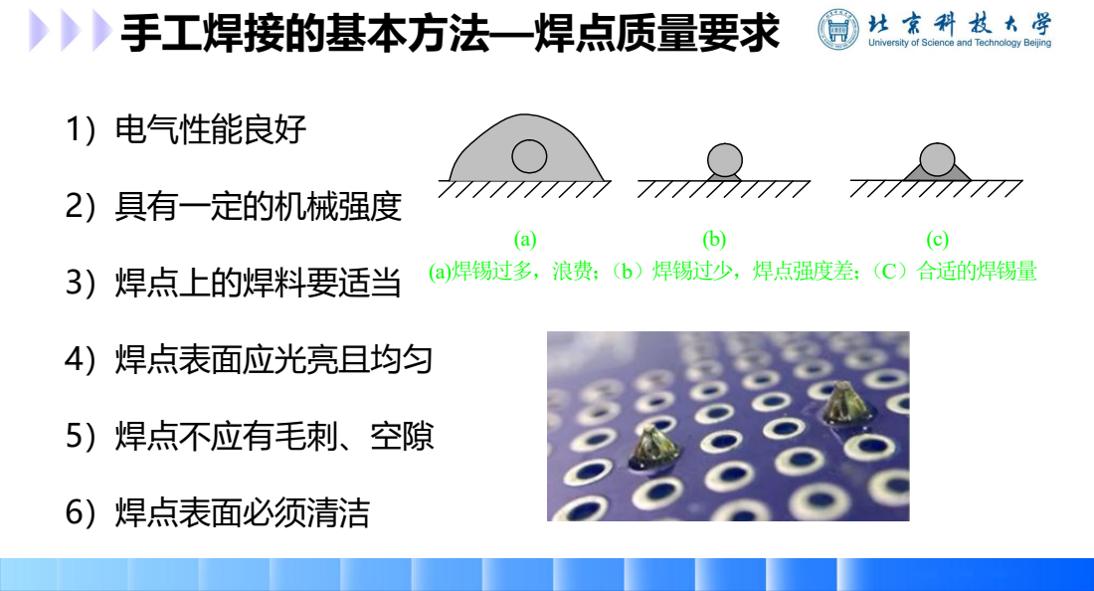
[picture p66: page 33]
1）电气性能良好; 2）具有一定的机械强度; 3）焊点上的焊料要适当; 4）焊点表面应光亮且均匀; 5）焊点不应有毛刺、空隙; 6）焊点表面必须清洁

(a)焊锡过多，浪费；（b）焊锡过少，焊点强度差；（C）合适的焊锡量

## 手工焊接的基本方法—直插元器件焊接

1）电烙铁的选用。由于铜箔和绝缘基板之间的结合强度、铜箔的厚度等原因， 烙铁头的温度最好控制在250~300℃之间，因此最好选用20W内热式电烙铁。 2）烙铁头的形状。烙铁头的形状应以不损伤印刷电路板为原则。 3）电烙铁的握法。焊接时，烙铁头不能对印刷电路板施加太大的压力，以防止 焊盘受压翘起。可采用握笔法拿电烙铁。
4）焊料和助焊剂的选用。对难焊的焊接点，可添加助焊剂。 5）焊接的步骤可按前述手工焊接的步骤进行。一般焊盘面积不大，可采用三步 操作法：a.加热被焊件，b.填充焊料，c.移开焊锡丝、移开电烙铁。为防焊接 温度过高，焊接时间一般以2~3s为宜。

## 手工焊接的基本方法—直插元器件焊接

6）元器件安装的技术要求
元器件安装应遵循先小后大、先低后高、先里后外、先易后难、先一般

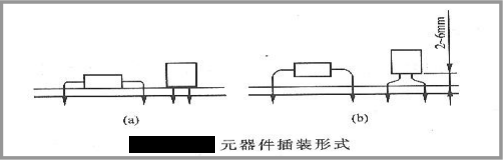
[picture p67: figure]

后特殊的基本原则。

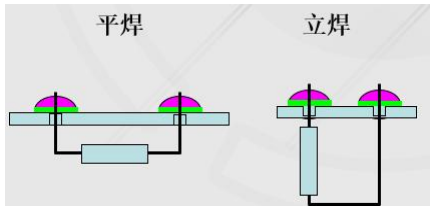
[picture p68: figure]

对于电容器、三极管等立式插装元件，应保留适当长的引线。一般要求 离电路板面2mm。
元器件引线穿过焊盘后应保留2~3mm的长度，以便引线打弯固定。

## 手工焊接的基本方法—贴片元器件焊接

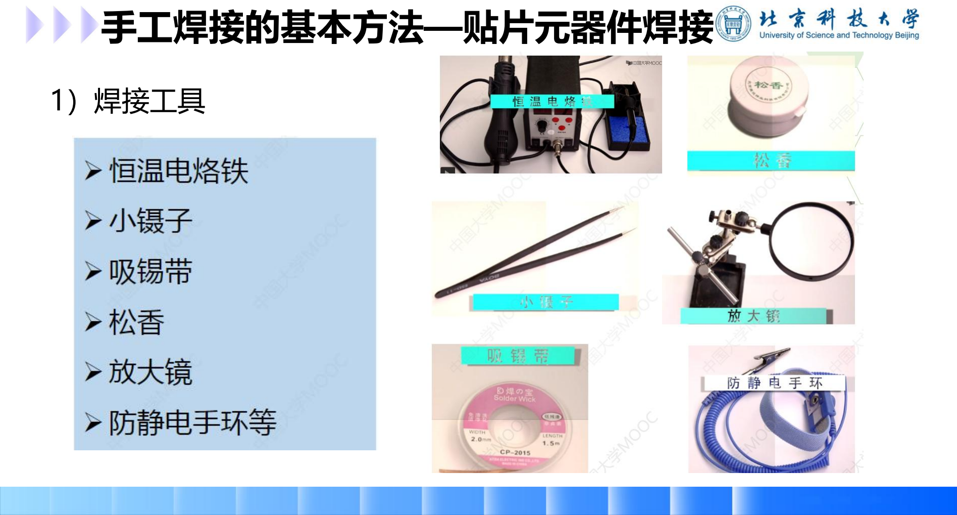
[picture p69: page 36]

1）焊接工具

## 手工焊接的基本方法—贴片元器件焊接

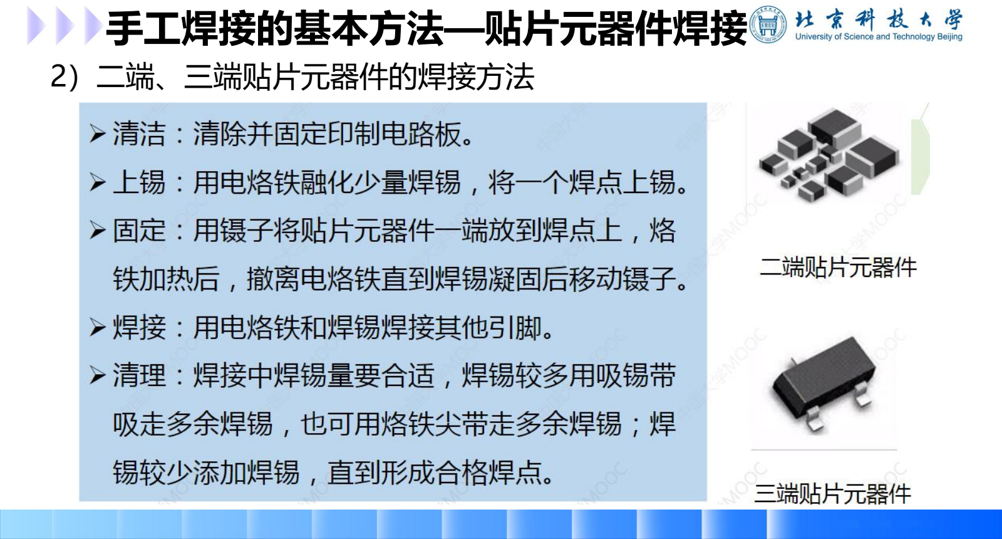
[picture p70: page 37]

2）二端、三端贴片元器件的焊接方法

## 手工焊接的基本方法—贴片元器件焊接

2）二端、三端贴片元器件的焊接方法

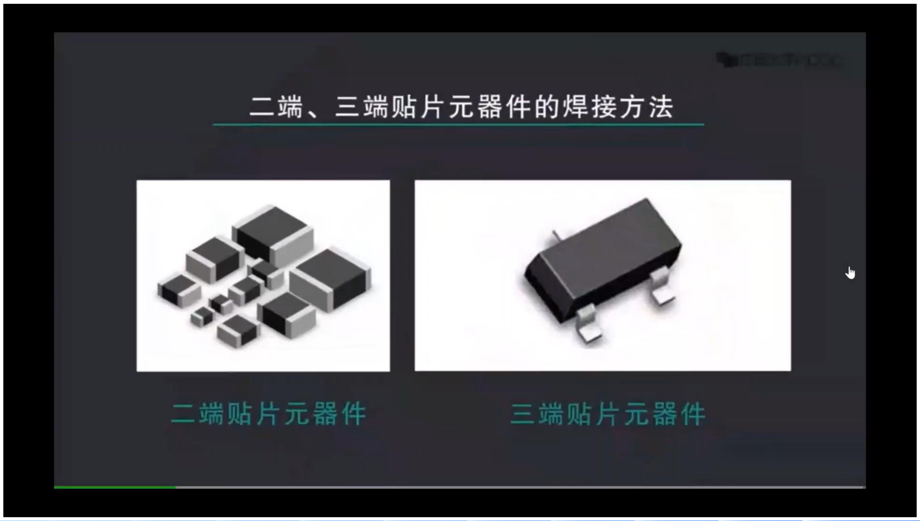
[picture p71: figure]

## 手工焊接的基本方法—贴片元器件焊接

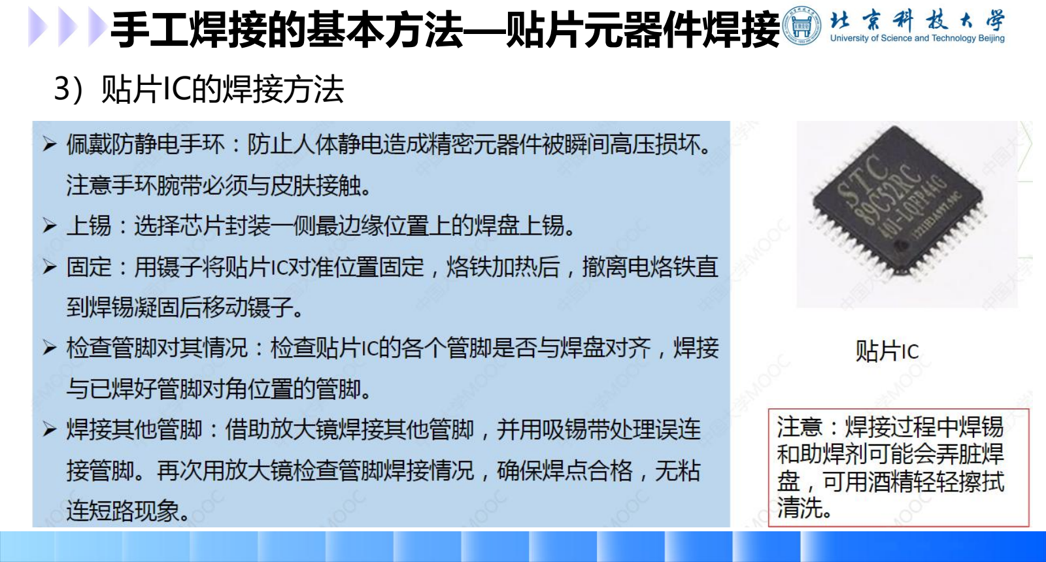
[picture p72: page 39]

3）贴片IC的焊接方法

## 手工焊接的基本方法—贴片元器件焊接

3）贴片IC的焊接方法

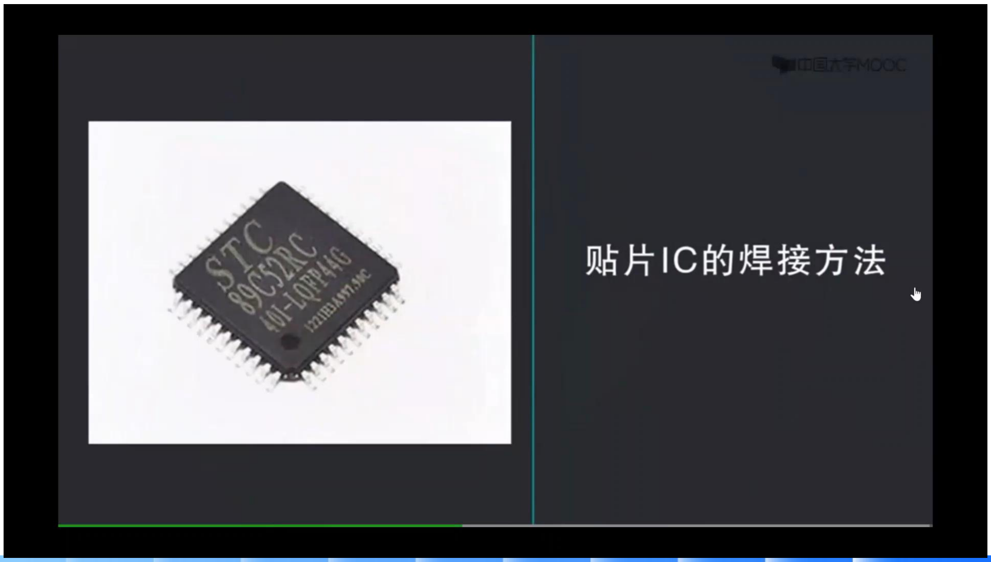
[picture p73: figure]

## 手工焊接的基本方法—拆焊技术

1）拆焊原则

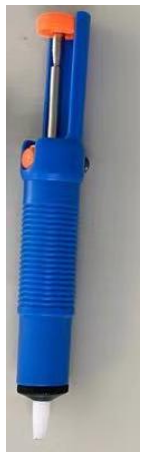
[picture p74: figure]
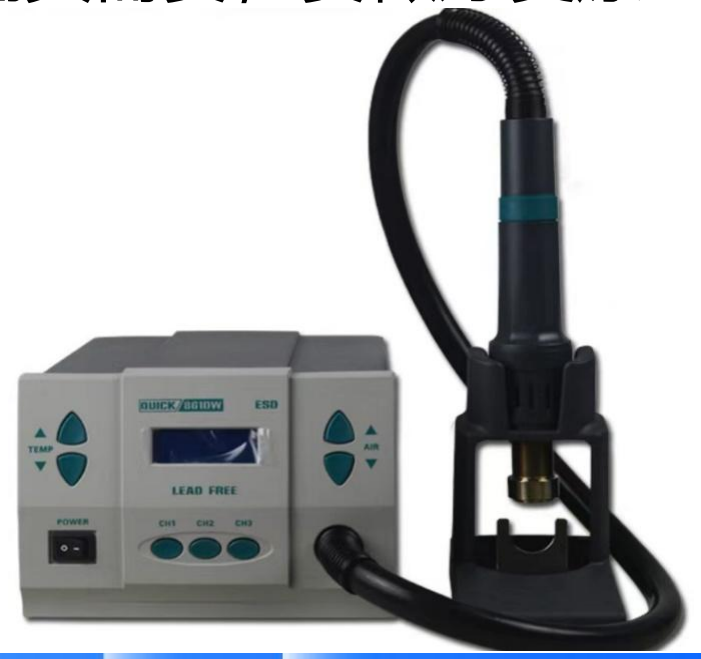
[picture p75: figure]

（1）不损坏拆除的元器件、导线、原焊接部位的结构件。 （2）拆焊是不可损坏印刷电路板的焊盘与印制导线。
（3）对已判断为损坏的元器件，可先行将引线剪断，再行拆除。这样可减少其他 损伤的可能性。
（4）在拆焊过程中，应尽量避免拆动其他元器件，如确实需要，要做好复原工作。 2）拆焊工具
电烙铁、镊子、吸锡器、热风枪
3）拆焊的操作要点
（1）严格控制加热的温度和时间
（2）拆焊时不要用力过猛
（3）吸去拆焊点上的焊料

目录

Ø 焊接基本知识

Ø 手工焊接工具及材料

Ø 手工焊接的基本方法

Ø 电子焊接工艺 Ø 焊接大“狮”赛介绍

## 电子焊接工艺

1

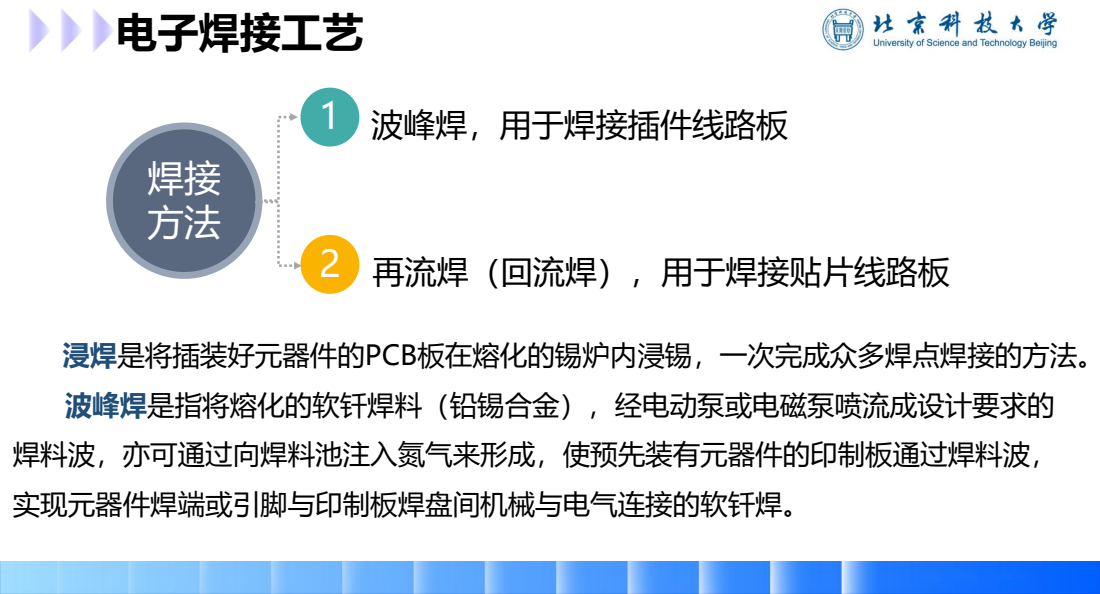
[picture p76: page 43]
波峰焊，用于焊接插件线路板

2 再流焊（回流焊），用于焊接贴片线路板

浸焊是将插装好元器件的PCB板在熔化的锡炉内浸锡，一次完成众多焊点焊接的方法。
波峰焊是指将熔化的软钎焊料（铅锡合金），经电动泵或电磁泵喷流成设计要求的
焊料波，亦可通过向焊料池注入氮气来形成，使预先装有元器件的印制板通过焊料波，
实现元器件焊端或引脚与印制板焊盘间机械与电气连接的软钎焊。

## 电子焊接工艺—波峰焊

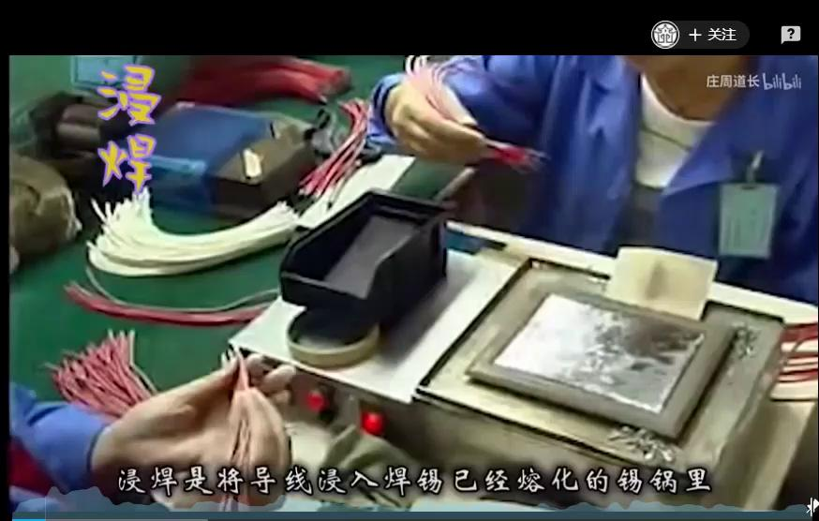
[picture p77: figure]

## 电子焊接工艺—再流焊

再流焊（回流焊）是预先在印制电路板焊接部位(焊盘)施放适量和适当形 式的焊料，然后贴放表面组装元器件，经固化(在采用焊膏时)后，再利用外部热 源使焊料再次流动达到焊接目的的一种成组或逐点焊接工艺。

### SMT（Surface Mount Technology）——表面组装技术

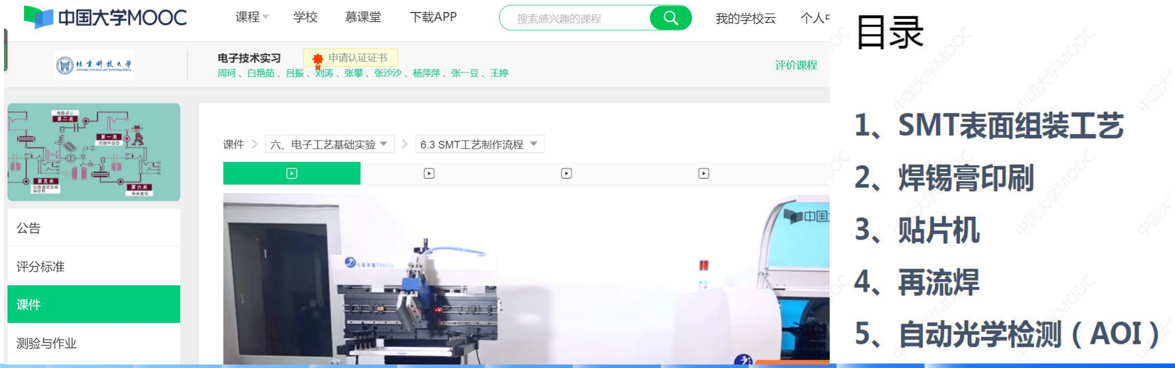
[picture p78: figure]

目录

Ø 焊接基本知识

Ø 手工焊接工具及材料

Ø 手工焊接的基本方法

Ø 电子焊接工艺

Ø 焊接大“狮”赛介绍

## 焊接大“狮”赛介绍

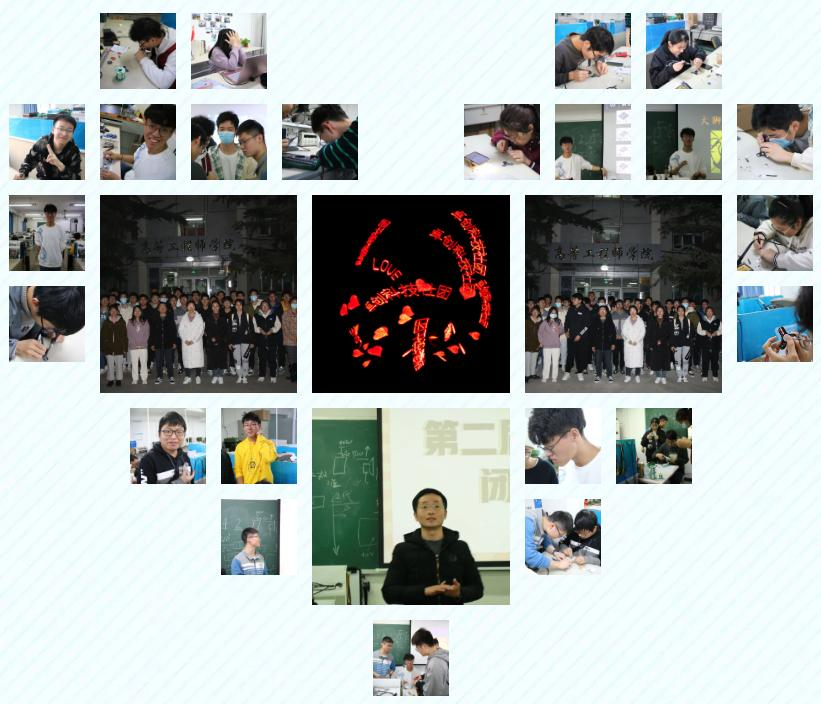
[picture p79: figure]

第一轮为直插套件的焊接，首先由硬件
部为同学们进行各种元器件、焊接工具、焊接
方法、安全注意事项的讲解，之后同学们进行
直插套件焊接及调试；
第二轮为贴片套件的焊接，首先由硬件
部回顾上一场出现的一些问题，再进行贴片元
器件焊接方法的讲解，之后同学们进行贴片套
件的焊接及调试。

焊接大“狮”赛是由高等工程师学院电子实习基地主办，由卓创科技社团负责 组织活动。旨在通过开展焊接培训，帮助同学们掌握焊接技能，提高动手实践能力。

## 焊接大“狮”赛介绍

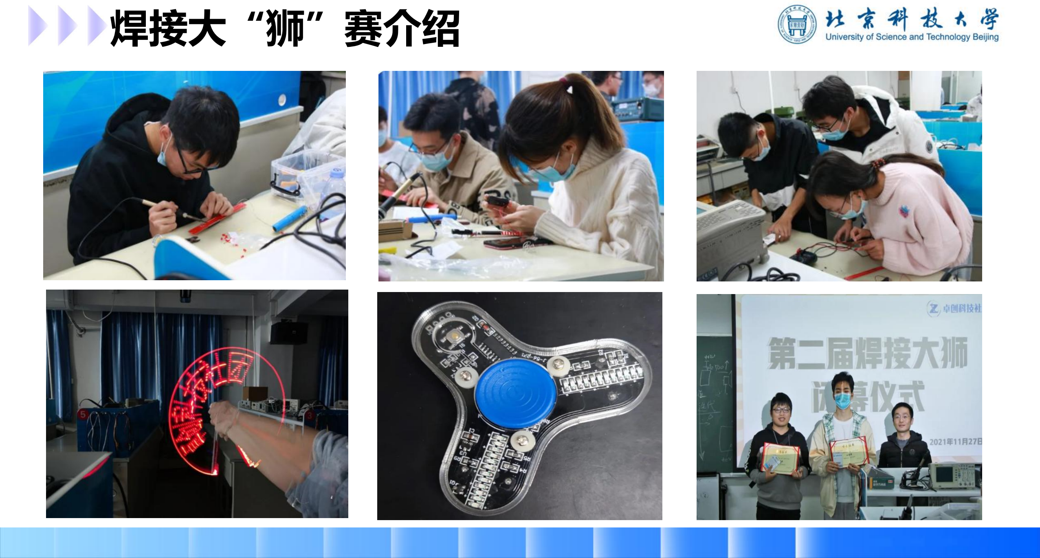
[picture p80: page 48]

## 焊接大“狮”赛介绍

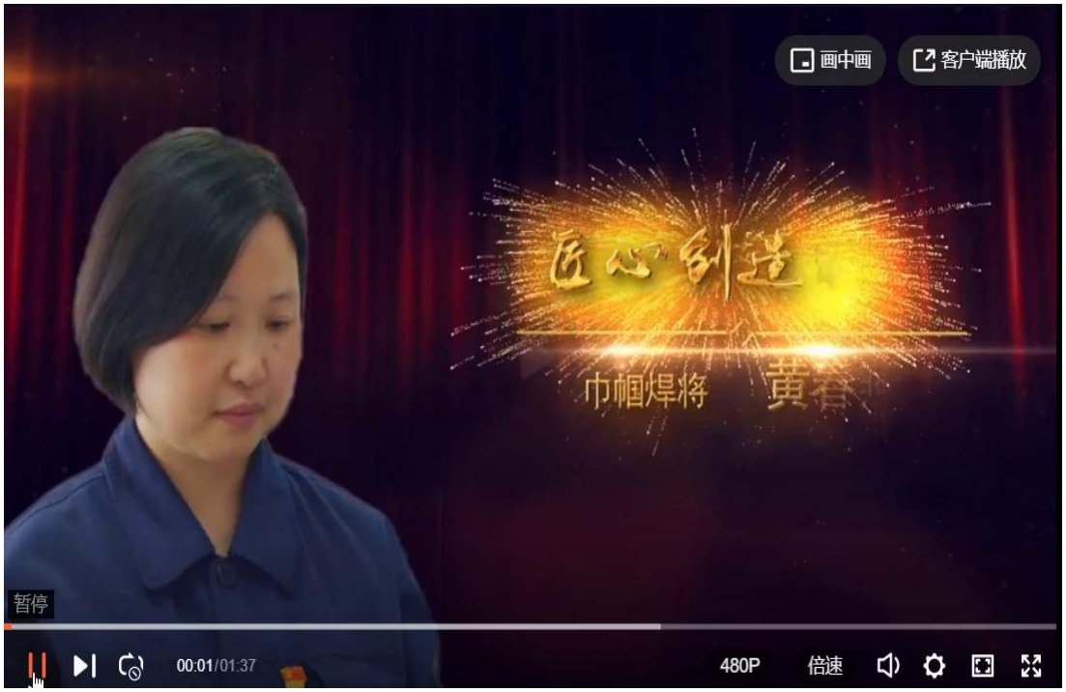
[picture p81: figure]

## 作业：完成焊接

1、准备焊接工具，做好烙铁头清洁
2、使用旧板进行拆焊练习，熟悉五步焊接法
3、对照元器件清单，认真核对并检查元器件
4、安装元器件，正式焊接语音小夜灯
5、检查焊点质量，出现虚焊漏焊之处要及时补焊
注意事项：
u推荐按照由低到高、先直插后贴片的焊接顺序
u安装时元器件尽量插到底
u有极性元件的管脚一定要焊接正确

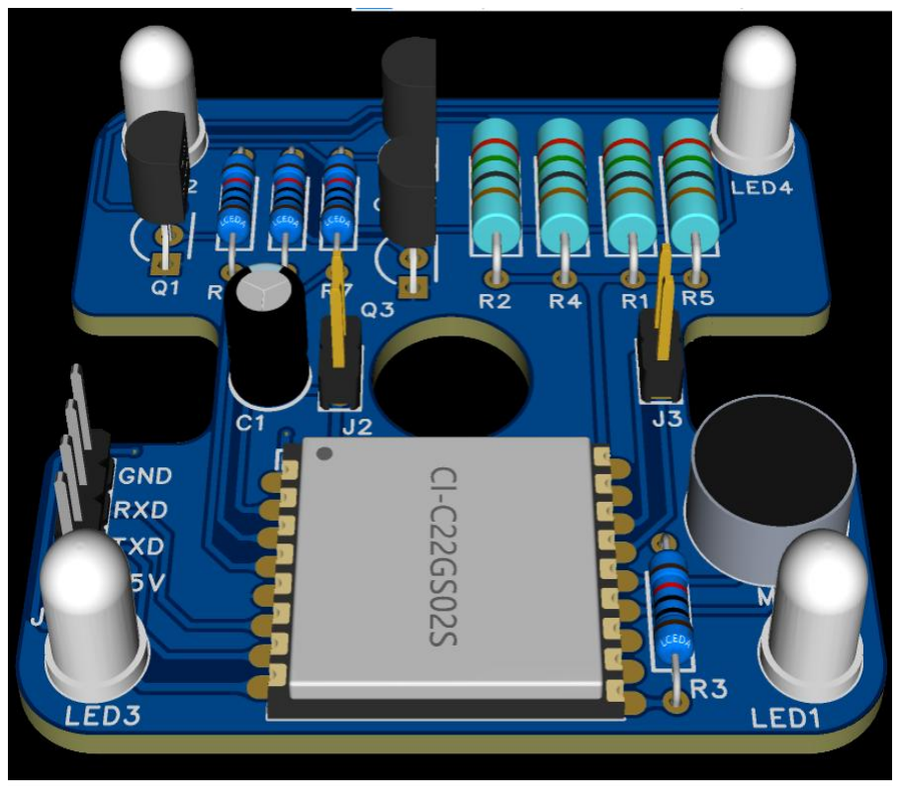
[picture p82: figure]
