Worigin0314/2025-USTB--IoT-Engineering--Electronic_Circuit_practice/(list of files, drawings)

Other design files:
ProDoc_AI-Light-PCB_2025-12-01.epro
ProPrj_24王起源U202442553_2025-12-01.epro
